retro-pc/korvet-extrom/img/top.jpg

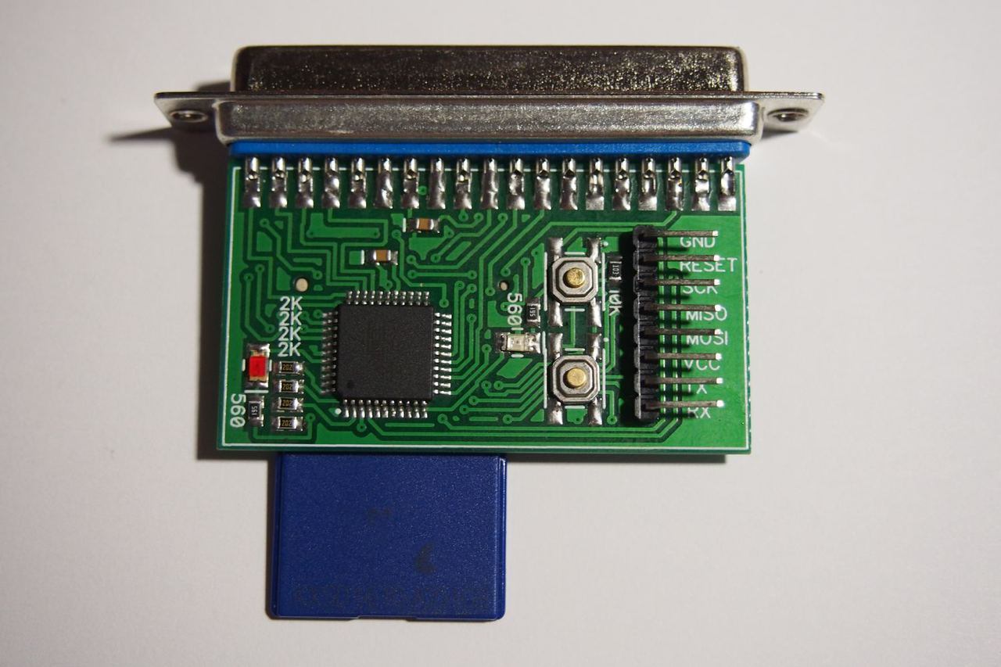
img/top.jpg
