retro-pc/korvet-extrom/img/bottom.jpg

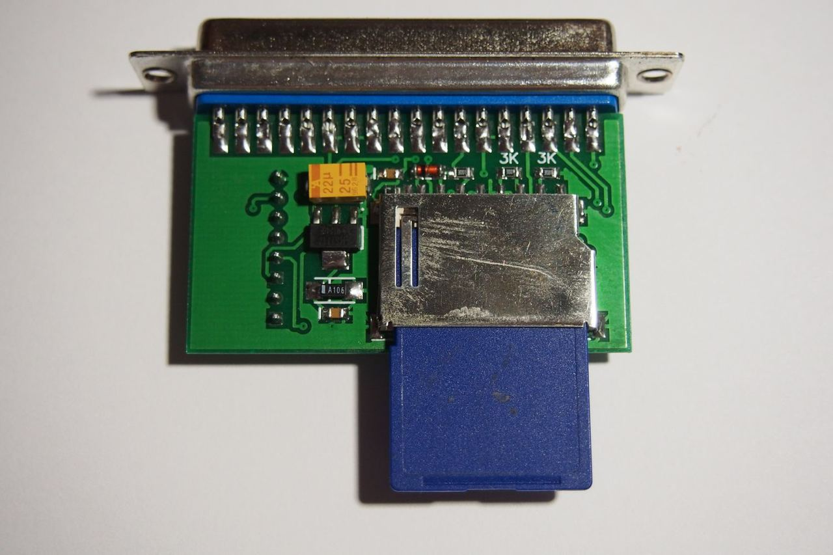
img/bottom.jpg
