retro-pc/korvet-extrom/README.md

# README #

Проект предназначен для эмуляции флоппи-дисков ПЭВМ "Корвет". Представляет собой внешний контроллер, подключаемый к боковому разъему ПЭВМ. Эмулирует до 4 дисководов (A-C) в виде образов, расположенных на карте SD. Позволяет производить загрузку системы. Работает в том числе и на ПК8010, не имеющем собственного контроллера дисковода.
