retro-pc/korvet-extrom/avr/readme.txt

2015-03-08:
 avr firmeare наконец получил номер версии, "1.3" и переформатирован.
 соответсвует последнему Stage2 (работает загрузка MicroDos)
 Stage1 перенесён с f600 на f500 т.к. портилась таблица клавиатуры в микродос.
 xboot переименова в Stage1 и добавлен скрипт его сборки
 в папку AVR добавлен скрипт заливки микроконтроллера и бинарники для прошивки.
