retro-pc/korvet-extrom/doc/hardware.odt

Korvet-EXTROM, Железо: схема, сборка и наладка.

В этом документе описывается схемотехника контроллера KORVET-EXTROM, даны рекомендации по его сборке и наладке. В принципе, грамотному электронщику читать его необязательно — для сборки и запуска достаточно принципиальной схемы и некоторого опыта наладки микроконтроллерных устройств. Однако, схемотехника контроллера довольно проста, и его сборка возможна всеми, кто умеет держать в руках паяльник и не боится им обжечься. И вот на них в основном и рассчитан дальнейший текст

1. Теория..

Основные принципы работы контроллера с программной точки зрения описаны в главном документе extrom.pdf. Здесь я опишу аппаратные особенности реализации контроллера. В принципе, для сборки и запуска контроллера данная информация не требуется, однако полезна для понимания процессов, происходящих в контроллере. Для лучшего понимания излагаемого материала желательно иметь перед глазами принципиальную схему корвета, которую легко найти в интернете

1.1 Загрузка из внешнего ПЗУ

ОПТС корвета умеет производить загрузку программ из ПЗУ, подключенного к боковому разъему. На этот разъем выведены все 3 канала параллельного интерфейса (ППИ) КР580ВВ55 #3 (эта микросхема стоит на плате рядом с боковым разъемом), а также некоторые системные управляющие сигналы и питание. ПЗУ к этому разъему подключается так: канал А ППИ подключен к шине данных ПЗУ, каналы В и С — соответственно к младшей и старшей части шины адреса. Сигнал Control через инвертор подключается к линии разрешения выхода ОЕ, а вывод CS ПЗУ заземлен. Таким образом, поддерживается ПЗУ любого объема вплоть до 64К. Реально, конечно, загрузить можно только чуть меньше 56К — младшие

8К адресного пространства заняты ОПТС, а в самых старших адресах находятся порты и АЦЗУ.

Загрузка происходит так. После окончания всех внутренних тестов, ОПТС устанавливает в 1 сигнал Control (это линия C7 параллельного интерфейса #2). Далее проверяется состояния сигнала IRQ7, также выведенного на боковой разъем. Если сигнал не изменил своего состояния, то делается вывод об отсутствии загрузочного ПЗУ и работа ОПТС продолжается как обычно. Если же сигнал IRQ7 также стал 1, то производится загрузка из ПЗУ. Следовательно, необходима перемычка между сигналами Control и IRQ7. Загрузка из ПЗУ производится в 4. этапа.

1. Из ПЗУ считывается информация о размере загружаемого блока и адресе размещения его в памяти.
2. Производится подсчет и проверка контрольной суммы ПЗУ. Если КС неправильная — загрузка прерывается с сообщением «Неверная КС».
3. 3. Из ПЗУ в оперативную память копируется весь загружаемый блок.
4. 4. Подсчитывается контрольная сумма загруженного в ОЗУ блока. Если она оказалась верной — происходит передача управления на адрес запуска, полученного ранее из заголовка.

При создании схемотехники контроллера EXTROM был учтен тот факт, что ОПТС читает ПЗУ в строго определенном порядке — байты 4, 5, 6, 7, а затем 3 раза весь блок данных. То есть четные и нечетные адреса всегда чередуются. Это позволило не подключать к контроллеру всю адресную шину (каналы B и C), а только один младший бит адреса — PB0. В самом деле — зачем нам полный адрес, если последовательность адресов заранее известна? У нас ведь используется не тупое ПЗУ, а настоящий микроконтроллер. Таким образом резко снижается количество проводов между контроллером и корветом, а канал B полностью освобождается для подключения различной пользовательской периферии — цифрового джойстика, мыши, итд.

Итак, наш контроллер умеет прикидываться внешним ПЗУ и эмулирует вышеописанный процесс загрузки. Канал А (данные) подключается к порту А микропроцессора Атmega32, единственная линия адреса PB0 — к биту 7 порта D, а сигнал Control (соединенный перемычкой с IRQ7) — ко входу внешнего прерывания INT0. По положительному фронту сигнала Control управляющая программа контроллера начинает выдавать в порт А последовательность данных, стробируясь по сигналу PD7. В результате в корвет передается блок данных размером 256 байт, содержащий загрузчик фазы 1 (что это такое и как он работает, описано в главном документе extrom.pdf). Затем загрузчик фазы 1 запускается, и далее уже самостоятельно, без участия ОПТС, взаимодействует с контроллером EXTROM.

1.2 Взаимодействие контроллера с корветом

ППИ КР580ВВ55 имеет замечательный режим работы — режим двунаправленной магистрали данных (режим 2). В этом режиме через канал А можно передавать по стробу данные как из корвета в контроллер, так и в обратную сторону. При этом данные, переданные одной стороной, защелкиваются во внутреннем регистре ППИ, и ждут, когда их заберет другая сторона. При наличии данных во внутреннем регистре выставляется флаг — OBF или IBF, в зависимости от того, в какую сторону передаются данные. Подробно, со всеми необходимыми диаграммами, этот режим описывается в документации на КР580ВВ55 (или ее прототип Intel 8255). Я же приведу список сигналов, используемых при взаимодействии контроллера EXTROM с корветом.

Ножка ППИ | Имя сигнала | Направление | Описание
PA0-PA7 | Data | I/O | Двунаправленная шина данных
PC4 | -STB | I | Запрос на передачу байта в корвет из контроллера
PC5 | IBF | O | Подтверждение приема байта корветом из контроллера
PC6 | -ACK | I | Подтверждение приема байта контроллером из корвета
PC7 | -OBF | O | Запрос на передачу байта из корвета в контроллер

После запуска загрузчика фазы 2 управляющая программа контроллера Extrom переходит в режим обработки команд. Команды формирует драйвер EXTROM, входящий в состав BIOS, или пользовательская программа (типа MOUNT). Каждая команда представляет собой 5-байтовый пакет - 1 байта кода команды, 3 байта параметров и 1 байт контрольной суммы. Драйвер последовательно записывает эти байты в порт А ППИ, который, в свою очередь, формирует строб -OBF. Контроллер EXTROM, получив строб, подтверждает прием отрицательным перепадом сигнала -ACK, и забирает данные из канала А. По окончании приема команды контроллер ее обрабатывает, и формирует ответный байт — 1 (OK) или 0 (Fail). Байт выставляется контроллером на выводы канала А и записывается в ППИ отрицательным фронтом -STB. Драйвер EXTROM, работающий в корвете, получает этот строб, и забирает данные из порта А.

Вот так происходит взаимодействие драйвера EXTROM в корвете и управляющей программы контроллера. Подробно этот протокол описывается в документе по API. В качестве примера программирования можно посмотреть исходники Extrom-BIOS (bios/exrsystem.asm) — процедуры EXR_GETBYTE и EXR_PUTBYTE, или исходники программы MOUNT — там те же самые процедуры написаны на С.

2. Схемотехника и сборка.

Теперь начинается практическая часть — как устроен контроллер и как его собрать. При изучении этого раздела следует иметь перед глазами принципиальную схему контроллера — она лежит в каталоге SCH дерева проекта. Схема нарисована в программе GPL EDA (geda), входящей в большинство дистрибутивов линукса. Для тех, кто хочет просто посмотреть схему, там же имеется вариант в виде картинки png.

2.1. Как устроен контроллер

Контроллер основан на микросхеме ATmega32 — однокристалльной микро-ЭВМ серии Atmel AVR. Она работает на частоте 8 МГц от внутреннего тактового генератора — это позволило не ставить на плату кварц и тем самым упростить схему. Питается контроллер прямо от шины +5V корвета, выведенной на боковой разъем. Собственно говоря, кроме контроллера на плате присутствует только слот для SD-карты и цепи ее питания и согласования уровней сигналов.

Дело в том, что карты SD требуют 3-вольтового питания и таких же уровней сигнала. А Atmega32 питается от 5 вольт и логические уровни у нее также 5-вольтовые. Чтобы не испортить карту, приходится устанавливать схему согласования. Она представляет собой 3 делителя напряжения — R2R6, R3R7, и R4R8. Эти делители стоят в цепях сигналов, идущих от AVR к карте (CS, DI и SCLK) и снижают уровень логической 1 до безопасных 2.8 V. Цепь R4VD2 стоит в цепи обратного (от карты в AVR) сигнала DO. Эта цепь защитная — предотвращает повреждение карты при случайном (например, из-за ошибок в программе) переключении порта PB6 на вывод. При нормальной работе эта цепь никакого влияния на сигнал не оказывает — стабилитрон VD2 всегда закрыт, а резистор R4 имеет сопротивление значительно меньшее, чем входное сопротивление порта AVR. В принципе, эту цепь можно и не ставить — стабилитрон VD2 убрать, а R4 заменить перемычкой. Управляющая программа уже отлажена и, надеюсь, таких ошибок не содержит. Однако, я бы не советовал экономить на такой мелочи — прошивка контроллера иногда обновляется, ошибки могут появиться, а убитую карту будет жалко.

Цепь питания SD-карты, формирующая напряжение 3.3V, построена на основе линейного регулятора LM317. Заменить ее можно на LM117 или LM1117 с любым буквенным индексом и в любом корпусе — потребляемый SD-картой ток очень мал, и греться микросхема не будет. В данном случае использован наиболее распространенный вариант микросхемы — с регулируемым выходным напряжением. Таких микросхем можно наковырять с неисправных материнских плат. Если повезет, то в продаже можно найти LM1117-3.3, на фиксированное выходное напряжение 3.3v — это позволит выкинуть из схемы резисторы R9 и R10. В принципе, можно еще более упростить цепь питания SD-карты — заменить LM317 на 3 последовательно включенных диода или стабилитрон 3.3v+резистор. Это уже каждый должен решать для себя сам. Я считаю, что вариант на интегральном стабилизаторе — самый безопасный для SD-карты.

Кроме AVR и цепей SD-карты, на плате также имеются 3 индикаторных светодиода (питание, Control, и активность ввода-вывода), 2 кнопки (сброс и очистка конфигурации), набор фильтровых конденсаторов, и соединители для подключения внешних интерфейсов — к корвету, программатору и терминалу.

2.2. Спецификация.

Далее приводится спецификация имеющихся на плате деталей — для зануд-педантов, и тех, кто пойдет в магазин закупать все детали за один раз.

Микросхемы
DD1 | Atmel ATmega32, с любым буквенным индексом
DA1 | LM317, LM117 или LM1117, регулируемая или с фиксированным 3.3v выходом
Диоды
VD1 | 1N4728A или любой другой маломощный стабилитрон на 3.3 или 3.0 V
VD2 | Красный светодиод с рабочим током не более 30 mA
VD3 | Желтый светодиод с рабочим током не более 30 mA
VD4 | Зеленый светодиод с рабочим током не более 30 mA
Резисторы
R1 | 560 * 0.25 W
R2-R5 | 2K * 0.25 W
R6-R8 | 3K * 0.25 W
R9 | 240 * 0.25 W
R10 | 430 * 0.25 W
R11 | 4.7 K * 0.25 W
R12-R13 | 560 * 0.25 W
Конденсаторы
C1 | 100.0 * 10V, электролитический
C2-C5 | 0.1 * 10V, керамический
C6 | 1000.0 * 16V, электролитический

Сразу хочу подчеркнуть, что не следует относиться к указанным выше номиналам как к точным и обязательным. Некоторые варианты замены деталей уже были рассмотрены выше. Рабочее напряжение керамических конденсаторов будет, разумеется, гораздо выше 10V — обычно 100V и выше. Здесь указано минимально возможное значение.Мощность резисторов необязательно должна быть именно 0.25W — можно ставить любые от 0.125 до киловатта... Их номиналы также могут изменяться в широких пределах — впрочем, если у вас есть радиолюбительский опыт, то вы сами решите, на что можно их заменить из того, что у вас лежит в загашнике. Если такого опыта нет — распечатывайте вышеприведенную таблицу, и в магазин за деталями.

Кроме вышеперечисленных деталей, потребуются еще некоторые компоненты.

- Кнопки SB1 (Config) и SB2 (Reset). Это могут быть любые кнопки, работающие на замыкание, как напаиваемые на плату, так и устанавливаемые отдельно на корпус. В принципе, для нормальной работы эти кнопки не особо и нужны — если не собираетесь заниматься доработкой контроллера и драйверов, можете их вообще не ставить.
- Разъем для SD-карты. Если готовый купить проблематично, можно выдрать из сдохшего картридера, фотоаппарата, КПК, навигатора итд. Можно установить micro-SD разъем — он компактнее. В качестве такого разъема можно использовать переходник SD-microSD, прилагающийся почти ко всем micro-SD картам, подпаявшись прямо к SD-контактам переходника.
- Разъем XP1. Это ответная часть бокового разъема корвета. В корветах применялись разные типы разъемов — и международный DB-37, и советский двухрядный РП-15-37, и трехрядный РП-15-50, может быть и еще какие-то. Если возникают трудности с приобретением ответной части данного разъема — просто замените в корвете советский разъем на стандартный DB-37, он вполне нормально подходит по размерам и впаивается в плату как родной.
- Разъем XP2. Используется для подключения отладочного терминала (описан далее). Можно установить штырьковый разъем типа IDC или PLS, в больших количествах встречающийся на материнских платах, или любой другой имеющийся под рукой 3-штырьковый разъем. Можно его вообще не устанавливать, а терминальный переходник подпаять прямо к ножке Atmega32, если терминал действительно понадобится.
- Разъем ХР3. Нужен для подключения программатора AVR, с помощью которого будет произведена запись прошивки в ATmega32. Можно также использовать IDC, PLS, если у вас уже есть готовый программатор — то надо использовать ответный разъем его кабеля. Можно просто подпаять проводки от программатора к микросхеме, или даже залить прошивку вне схемы, воткнув ATmega48 во внешний программатор — тогда разъем не потребуется.
- Колодка для микросхемы DD1 — DIP-48W. Нужна, если используется микросхема в DIP-корпусе. Если используется TQFP корпус для SMD-монтажа — то колодка, естественно, не нужна. Можно и DIP-корпус впаять прямо в плату — но лучше, все же, поставить колодку.

2.3. Конструкция.

Существует множество вариантов сборки данного устройства. Поскольку схема его предельно проста, то наиболее оптимальный вариант — сборка на макетной печатной плате навесным монтажом. Для этого потребуется небольшая макетная печатная плата, в которую с одной стороны вставляются все компоненты, а с другой стороны они соединяются монтажными проводами. Затем плата вставляется в подходящий по размерам корпус — и контроллер готов.

Другой вариант — сделать печатную плату. Этот вариант подходит только для опытных радиолюбителей, имеющих соответствующий практический навык. В результате, при использовании SMD-компонентов, можно получить очень компактную конструкцию, буквально умещающуюся в корпусе разъема. Развести плату можно в том же gEDA, в котором нарисована принципиальная схема устройства.

При сборке и разводке платы следует учитывать расположение фильтрующих конденсаторов. Керамический конденсатор С5 и электролитический C6 следует располагать непосредственно возле ввода кабеля, идущего к разъему ХР1 (или около самого разъема, если он впаян в плату). Конденсаторы С3 и С4 располагаются с обоих сторон процессора DD1, подключаясь прямо к выводам питания. Конденсатор С2 подключается как можно ближе к выводам питания SD-карты. Неправильное расположение фильтрующих конденсаторов приведет с странным и совершенно необъяснимым глюкам в работе контроллера. Земляную шину следует проложить толстым проводом по периметру платы, и стараться подключать все земляные точки непосредственно к ней. Шину питания +5V также следует выполнять более толстым проводом. В противном случае в проводах питания возникают импульсные провалы напряжения, что может вызывать сбои в работе процессора.

Отдельно требует пояснения ситуация с цоколевкой разъема ХР1. Дело в том, что нумерация выводов в стандартном разъеме DB-37 и советском РП-15-37 зеркально противоположны. На схеме указана нумерация для DB-37. В следующей таблице показано соответствие нумерации сигналов DB-37 и РП-15-37:

Сигнал | РП-9-37 | DB37
+5v | 25-27 | 30-32
A0 | 34 | 23
A1 | 35 | 22
A2 | 36 | 21
A3 | 37 | 20
A4 | 19 | 1
A5 | 18 | 2
A6 | 17 | 3
A7 | 16 | 4
Control+IRQ | 32+33 | 24+25
B0 | 3 | 17
C4 | 8 | 12
C5 | 9 | 11
C6 | 10 | 10
C7 | 11 | 9
GND | 12-13 | 7-8

Для трехрядного разъема РП-15-50 цоколевка не приводится — его у меня просто нет. С ним вам придется разобраться самостоятельно — или плюнуть на него и впаять обычный DB-37.

2.4. Сборка и начальная проверка.

Конечно, для данной схемы действует обычное правило цифровых схем — правильно собранная конструкция начинает работать сразу и в наладке не нуждается. Однако не торопитесь сразу подключать все это к корвету. Результат может оказаться совершенно другим — например, выход из строя процессора или SD-карты. Ибо собрать даже такую простую схему сразу и без ошибок удается далеко не всем. Поэтому предлагаю не торопиться.

Вначале следует аккуратно спаять схему. Процессор в колодку пока устанавливать не надо, как и SD-карту в слот. После сборки внимательно, по схеме, проверьте все соединения между компонентами. Их не так уж и много, и вся проверка займет времени не больше, чем обычно уходит на кружку пива. Лучше проверять соединения не только визуально, но и прозвонить их омметром — поскольку бывают незаметные на глаз плохие пайки. Особо тщательно вследует проверить распайку кабеля от платы до разъема ХР1 — ошибки здесь могут привести, например, к попаданию напряжения +12V на сигнальные входы процессора, что приведет к его мнгновенной смерти.

Затем схема, без процессора, подключется к выключенному корвету. Омметром вызваниваем земляную шину и шину +5V непосредственно на разъем питания корвета. Затем включаем корвет, берем вольтметр, и измеряем напряжение непосредственно на колодке процессора, между ножками VCC и GND — там должно быть от 4.5 до 5.2 V. Затем измеряем выходное напряжение LM317 непосредственно на колодке SD-карты — должно быть от 2.8 до 3.6 V.

Только после того, как вы убедитесь в правильности всех питающих напряжений, можно вставить в колодку процессор и перейти к следующему этапу — заливке прошивки.

2.5. Прошивка процессора.

В процессоре ATmega32 имеется 3 типа памяти — RAM, Flash ROM и EEPROM. Соответственно, требуется залить в него 2 отдельные прошивки — Flash и EEPROM. Первая из них — это управляющая программа процессора, вторая — загрузчик фазы 1, хранящийся в EEPROM для ускорения доступа у нему. Управляющая программа берется из файла avr/extrom.hex, загрузчик фазы 1 — из файла loader/xboot/xboot.bin.

Для заливки прошивок используется специальное устройство — внутрисхемный программатор AVR, подключающийся к разъему XP3. Программаторов существует огромное количество — как промышленных, например STK200 или STK500, так и самодельных. Множество описаний их конструкций можно найти в интернете. У радиолюбителей, имеющих дело с микроконтроллерами AVR, уже имеется какой-либо программатор. Но что делать тем, кто видит AVR впервые в жизни, и не планирует больше никогда с ними иметь дело? Можно, конечно, купить готовый простейший программатор — стоят они совсем недорого. Но можно обойтися и подручными средствами. Для этих целей давно разработана конструкция программатора, представляющая из себя 5 проводков, подключаемых к LPT-порту компьютера. То есть там кроме проводов ничего больше и нет. Вот таблица подключения сигналов программирования к LPT-порту:

Сигнал | Ножка AVR | Вывод LPT
Reset | 1 | 9
MOSI | 6 | 7
MISO | 7 | 10
SCK | 8 | 6
GND | 11 или 31 | 25

Для защиты LPT-порта лучше включить в разрыв каждого из сигнальных проводов (кроме земли, конечно), резистор 150-300 ом. Но можно и просто распаять кабель между XP3 и разъемом DF-25M. Длина такого кабеля должна быть минимальна — не более 20 см. LPT порт можно использовать как встроенный в мать, так и дополнительный на PCI/PCIE — картах.

Если в вашем компьютере совсем нет LPT-порта, то можно сделать переходник на COM-порт. Он, конечно, сложнее, но ненамного:

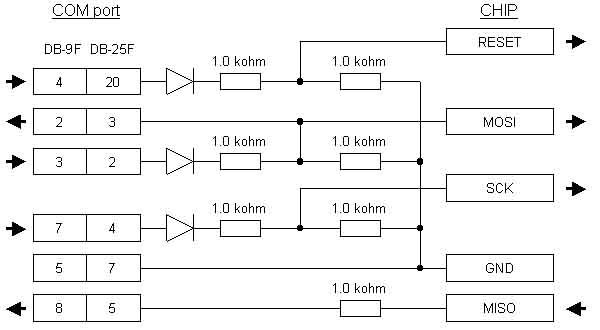
[picture p3: figure]

С этим переходником будут работать настоящие COM-порты, стоящие на материнских платах или дополнительных PCI/PCIE картах. Переходники USB-Serial, скорее всего, работать не захотят.

Для заливки прошивок потребуется специальная утилита — программатор AVR. Я рекомендую использовать широко распространенную программу AVRDUDE, имеющуюся почти во всех дистрибутивах линукса. Одним из параметров командной строки указывается тип программатора. Для 5-проводного LPT-программатора запускать программу следует так:

$ avrdude -c stk200 <ключи программирования>

Для использования программатора на последовательный порт следует предварительно отредактировать файл /etc/avrudue.conf. В этом файле следует найти такую секцию:

# unknown (dasa3 in uisp)

# reset=!dtr sck=rts mosi=txd miso=cts

programmer

id = "dasa3";

desc = "serial port banging, reset=!dtr sck=rts mosi=txd miso=cts";

type = "serbb";

connection_type = serial;

reset = ~4;

sck = 7;

mosi = 3;

miso = 8;

Здесь следует убрать знак тильды «~» в строке reset = ~4;

Ключи запуска AVRDUDE будут выглядеть так:

$ avrdude -c dasa3 -P /dev/ttyS0 <ключи программирования>

Вместо /dev/ttyS0 следует указать имя того последовательного порта, к которому подключем программатор.

Порядок прошивки будет такой — вначале устанавливаются Fuse-биты, затем заливается Flash, и потом EEPROM. Fuse-биты для нашего варианта контроллера будут такими: hfuse=0xd1 lfuse=0xe4.

Зашивка fuse-битов:

$ avrdude <ключи типа программатора> -p m32 -U lfuse:w:0xe4:m -U hfuse:w:0xd1:m

Заливка flash:

$ avrdude <ключи типа программатора> -p m32 -U flash:w:extrom.hex:i

Заливка EEPROM:

$ avrdude <ключи типа программатора> -p m32 -U eeprom:w:xboot.bin:r

Если все прошивки окончились успешно, отключите от платы программатор и нажмите кнопку Reset. Должен замигать красный светодиод VD2 — значит, управляющая программа жива и собщает нам о том, что не нашла SD-карту.

2.6. Проверка загрузчика фазы 1.

Подключите корвет к монитору, контроллер EXTROM с прошитым процессором — к боковому разъему корвета, и включите питание. На контроллере должны включиться светодиоды: зеленый (питание) и желтый (Control). Вслед за тестом ОПТС желтый светодиод погаснет, экран должен очиститься, и в верхем левом углу появится надпись BOOT:. Это говорит о том, что загрузчик фазы 1 считан из EEPROM и корректно передан в контроллер. Если все так и есть, то вам повезло и можно переходить к следующему пункту 2.6. Иначе что-то работает не так. В этом случае обращайтесь к главе 3, раздел неисправностей загрузки фазы 1.

2.7. Подготовка SD-карты

Теперь настало время заняться SD-картой. Еше раз замечу, что для работы в контроллере подходят только SD- и microSD-карты емкостью до 2Гб включительно. Более емкие карты работают по протоколу SDHC и текущей версией микропрограммы не поддерживаются. Карту необходимо отформатировать в файловую систему FAT16:

$ mkfs.vfat -F 16 -n EXTROM /dev/sdb

Обратите внимание, что MBR на карте создавать не надо. Соответсвенно, файловая система создается именно на основном устройстве (в данном случае - /dev/sdb), а не на разделе (типа /dev/sdb1). Отформатировав карту, выньте ее из картридера и снова вставьте — это позволит ОС автоматически смонтировать новую файловую систему.

Далее на карту следует скопировать ряд обязательных файлов. В следующей таблице показаны, какие файлы необходимы на карте и где их искать в дереве проекта:

Имя файла | Откуда | Описание
LOADER.BIN | loader/stage2 или loader/smldr | Загрузчик фазы 2
SYSTEM.BIN | bios/system.bin | Стандартный биос CP/M 2.2
MICRODOS.BIN | bios/microdos.bin | Стандартный биос Microdos
EXRTOOLS.DSK | mount/exrtools.dsk | Инструментальный диск
DISK/ | | Каталог по умолчанию для образов дисков
DISK/DISKA.BIN | disk/diska.kdi | Тестовый загрузочный диск с CP/M 2.2
ROM7.BIN | loader/KTDP.BIN | Диагностическая программа КТДП

Обратите внимание, что контроллер работает только с файлами, имена которых содержат только английские буквы, а длина имени не превышает 8.3 (8 байт имени и 3 байта расширения файла). Кроме вышеперечисленных файлов, в каталог DISK можно положить другие образы дисков. Если их назвать DISKB.KDI, DISKC.KDI, DISKD.KDI, то они по умолчанию автоматически смонтируются при старте системы. Можно также создать другие каталоги с образами дисков. Но это все лучше отложить на потом, когда контроллер начнет правильно функционировать.

Записав на карту все необходимые файлы, размонтируйте карту, выньте ее из картридера и вставьте в контроллер. Начинается этап окончательной проверки его работы.

2.8. Окончательная проверка контроллера.

Подключите к корвету контроллер со вставленной картой, и включите корвет. После окончания тестов ОПТС экран должен очиститься, затем будет выведена служебная информация загрузчика, стандартный загрузочный заголовок ОС CP/M и, наконец, промпт командной строки A>. Поздравляю — контроллер полностью и правильно заработал с первой попытки. Можете начинать работу с ним. Вот теперь можно забить карту под завязку образами дисков, разобраться с командой mount

и, наконец, погрузиться в 8-разрядный мир 80-х годов прошлого века.

Однако, вполне возможно, что все будет работать не так как хотелось, или вообще не заработает. Тогда вам предстоит увлекательный процесс поиска неисправности. Этому посвящена следующая глава.

3. Поиск и устранение неисправностей.

Эта глава нужна тем, у кого что-то не заработало. Если все уже работает с первой попытки — то этот раздел можно совершенно спокойно пропустить.

    3.1 Отладочный терминал.

Как и в любой уважающей себя микропроцессорной системе, в нашем контроллере имеется отладочный последовательный порт. В него контроллер выводил протокол своей работы, различные отладочные сообщения, информацию о встреченных ошибках, итд. Использование этого последовательного порта сильно облегчает жизнь в процессе отладки контроллера, а также при доработках его управляющей программы. Конечно, если у вас все уже работает, а прошивку контроллера вы дорабатывать не собираетесь, то этот порт вам не нужен. Иначе первое, что вам предстоит сделать — это подключить этот порт к своему компьютеру

Отладочный порт реализован на базе стандартного UART, встроенного в Atmega32. Используется только передатчик порта TxD, приемник RxD в текущей версии прошивки не используется, хотя драйвера для него на всякий случай туда добавлены. То есть пока мы можем только наблюдать за работой контроллера. Сигнал TxD, выведенный на разъем отладочного терминала, имеет стандартный TTL-уровень 5V с отрицательной полярностью сигнала, и непригоден для непосредственного подключения к последовательному порту PC. Требуется согласующий переходник, который можно получить разными способами.

Можно взять дата-кабель от древних сотовых телефонов. В те времена, когда телефонные аппараты не снабжались поголовно USB, для подключения к компьютеру часто использовался встроенный в телефон последовательный порт. Существовали кабели для подключения такого телефона к USB или COM-порту. Этот кабель вполне можно использовать для подключения к нашему контроллеру.

Если такого кабеля нет — а найти его с каждым годом все труднее, то можно спаять простенький переходник на последовательный порт. Состоит этот переходник из 1 инвертора:

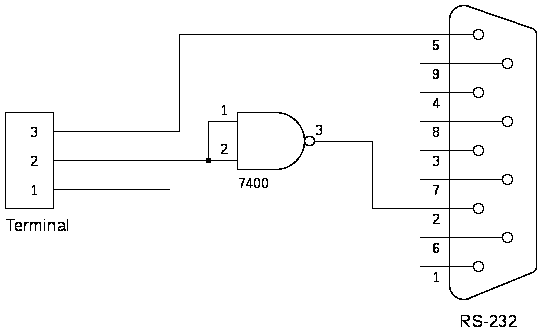
[picture p4: figure]

Здесь можно использовать любой TTL-инвертор — например К155ЛА3, К555ЛН2, ну или что у вас найдется под рукой. Запитать микросхему можно прямо от шины +5V контроллера. Такой переходник будет работать как с полноценным последовательным портом, встроенным в материнскую плату или PCI/PCIE карту, так и с USB-Serial кабелями.

Параметры последовательного порта: скорость 1000000 Bps, формат кадра — 8-N-1. Если ваш последовательный порт не умеет работать на таких высоких скоростях, то можно установить стандартную скорость 115200, пересобрав прошивку такой командой:

$ make -B LOWSPEED=1

При этом производительность контроллера может немного ухудшиться, но зато он будет гарантированно работать с любым последовательным портом.

Для наблюдения за отладочным протоколом можно использовать любую терминальную программу, понимающую кодировку UTF-8. Я рекомендую использовать стандартную терминальную программу minicom, имеющийся в каждом дистрибутиве linux. Запускать ее надо так:

$ minicom -D /dev/ttyS0 -b 1000000 -8 -R utf8 -w

Здесь ttyS0 — имя устройства последовательного порта, к которому подключен переходник (для USB-Serial кабелей будет, например, ttyUSB0 или ttyACM0). 1000000 — скорость последовательного порта, -8 — не отрезать старший бит, -w — заворачивать длинные строки, -R utf8 — кодировка символов.

Итак, подключаем отладочный терминальный порт через переходник к компьютеру, запускаем minicom, и включаем корвет. В терминале должны появиться примерно следующие строки:

*** Extrom - SD ***

CARD MID=2 OID=4d54

Product - SD02G

rev 56 serail 13224

-- Корневой каталог карты --

0: KDI2 <DIR>

1: LOADER BIN 768

2: SYSTEM <DIR>

3: SYSTEM BIN 10240

4: TOOLS <DIR>

5: ROM6 BIN 1024

6: DISK <DIR>

7: XKDI <DIR>

8: MOUNT CFG 126

9: ROM1 BIN 4608

10: ROM3 BIN 48896

11: ROM5 BIN 1024

12: KDI3 <DIR>

13: KDI4 <DIR>

14: PLDISK <DIR>

15: TD0 <DIR>

16: IC <DIR>

17: ROM0 BIN 16384

Всего 18 файлов

В первых строках идет информация о вставленной SD-карте. Затем — корневой каталог этой карты. После прохождения тестов ОПТС начнется загрузка системы, и на терминал будут выведены следующие строки:

Загрузка фазы 2

Loader file: LOADER.BIN

Loader base: 20

Loader size: 3

Block # 5

Загрузка фазы 2 окончена

Disk A: DISK/DISKA.KDI

Disk B: DISK/DISKB.KDI

Disk C: DISK/DISKC.KDI

Disk D: DISK/

Defdir: DISK

Mount A: DISK/DISKA.KDI SPT=40 st=2

Mount B: DISK/DISKB.KDI SPT=40 st=2

Mount A: SYSTEM.BIN SPT=40

RRRRRRRRRRRRRRRRRRRRRRRRRRRRRRRRRRRRRRRRRRRRRRRRRRRRRRRRRRRRRRRRRRRRRRRRRRRRRRRR

Здесь можно увидеть поблочный процесс загрузки фазы 1, процесс монтирования образов по умолчанию, и загрузку системы из образа диска А.

Если что-то пойдет не так, на терминал будет выведена информация о произошедшей ошибке. Они описаны далее, при рассмотрении различных вариантов неисправностей.

3.2 Проблемы с запуском AVR.

Может оказаться так, что после включения питания на терминал не будет выведено ничего. И красный индикаторный светодиод ни разу ни мигнет. Это означает, что наш процессор Atmega32 вообще не запускается. Причин тут может быть несколько.

- Неправильно прошиты биты FUSE. Аккуратно прошейте их еще раз. Впрочем, возможна такая комбинация битов, при которой программатор больше не сможет связаться с процессором. Например, выбрано внешнее тактирование вместо внутреннего RC-генератора. Или запрещено последовательное программирование. В этом случае придется принимать меры по восстановлению процессора. Здесь я их описывать не буду — в интернете достаточно информации о восстановлении AVR с неправильно прошитыми FUSE.

- Неправильно прошита основная прошивка. Прошейте ее еще раз, и обратите внимание на проход верификации — не появится ли там ошибок.

- Процессор не получает питания. Например, не все ножки Vcc и GND распаяны. Впрочем, в этом случае у вас вообще не получится зашить процессор.

Если процессор исправен, питается правильно, зашит корректной прошивкой и fuse, то он обязан запуститься. При этом, если красный светодиод моргает, а в терминале ничего нет — то, очевидно, у вас или неправильно собран переходник, или ваш последовательный порт не поддерживает скорость 1000000. Пересоберите прошивку на скорость 115200, как описано выше, перезашейте ее в процессор, и попробуйте запустить систему еще раз. Если и теперь терминал не заработал — то придется брать осциллограф и смотреть сигналы на выходе TxD и далее вплоть до последовательного порта компьютера. Описание работы с осциллографом выходит за рамки этого документа — если он у вас есть, то вы и так знаете как им пользоваться. Если нет — обращайтесь к знакомым электронщикам за помощью.

3.3 Проблемы с загрузчиком фазы 1.

Загрузчик фазы 1 — это небольшая программа, хранящаяся в EEPROM контроллера, и передающаяся в корвет в режиме эмуляции внешнего ПЗУ. При вынутой SD-карте этот загрузчик выводит на экран надпись BOOT: и останавливает систему. Рассмотрим возможные неисправности.

- После теста ОПТС запускается встроенный бейсик или идет загрузка с дисковода. Это происходит, если не установлена перемычка между сигналами Control и IRQ7 на разъеме XP1. Также вы могли напутать с цоколевкой этого разъема.

- При включении не зажигается желтый светодиод Control. Это значит, что сигнал Control не доходит до платы контроллера. Или он припаян не к той ножке разъема XP1, или имеется ошибка в монтаже. В редких случаях возможна неисправность ППИ2 на плате корвета.

- На экране появляется надпись «НЕПРАВИЛЬНАЯ КС». Вот тут возможно очень много вариантов.

1. Неправильно прошит загрузчик фазы 1 в EEPROM. Прошейте его еще раз, и обратите внимание на результат верификации прошивки.

2. Неправильно подключены к контроллеру линии канала данных А или адресная линия B0. Следует омметром, при выключенном корвете, прозвоить каждый из сигналов от ножек ППИ3 ВВ55 до ножек Atmega32, согласно следующей таблице:

Сигнал | Ножка ВВ55 | Ножка Atmega32
D0 | PA0(4) | PA0(40)
D1 | PA1(3) | PA1(39)
D2 | PA2(2) | PA2(38)
D3 | PA3(1) | PA3(37)
D4 | PA4(40) | PA4(36)
D5 | PA6(39) | PA5(35)
D6 | PA7(38) | PA6(34)
D7 | PA6(37) | PA7(33)
A0 | PB0(18) | PD7(21)

Нумерация выводов указана для DIP-корпуса AVR. Для TQFP-корпуса нумерация будет, естественно, другой. Сигналы следует прозванивать не только от ножки ППИ до ножки AVR, но и на соседние ножки — бывают межвыводные замыкания на плате или в кабеле.

Если все соединения правильны, то, возможно, у вас неисправен ППИ3 ВВ55, стоящий в корвете. Проверить его можно разными способами, но для большинства из них требуется, как минимум, осциллограф. Если его нет, то предлагаю методику проверки порта с помощью обычного вольтметра. Для этого нам необходмо записать в порт А микросхемы ВВ55 некоторые образцовые байты, и проверить состояние выходных ножек порта. Проверку следует производить при отключенном от разъема контроллере EXTROM.

Работать с портами можно из разных программ — под CP/M это удобнее делать с помощью отладчика DDT или системы программирования FORTH. Далее я буду использовать для этих целей встроенный бейсик. Он не так удобен, зато имеется в каждой машине. В следующей таблицы показаны адреса портов ППИ3 в адресном пространстве бейсика (карта 40h):

Порт ВВ55 | Адрес (HEX)
Канал А | FB08
-Канал B | FB09
Канал С | FB0A
Регистр управляющего слова | FB0B

Вначале надо запрограммировать ППИ в режим вывода информации. Сделать это можно такой командой:

POKE &HFB0B,0

Затем записываем ноль в канал А:

POKE &HFB08,0

Теперь берем вольтметр, и убеждаемся, что на всех выводах канала А установился логический 0 — напряжение не более 0.8 V. Затем записываем 1 в бит 0 канала A:

POKR &HFB08,1

Берем вольтметр, убеждаемся, что на выводе PA0 появилась единица — напряжение выше 3.8V. На остальных выводах канала А должен остаться 0. Теперь таким же образом последовательно устанавливаем биты 1, 2, и так далее до 7, записывая в порт FB08 числа 2, 4, 8, 16, 32, 64, 128. На соответствующей ножке канала А должна появится 1, на остальных — удерживаться 0. Если на какой-либо из ножек появляется напряжение, среднее между 0 и 1, то эта ножка замкнута на какую-либо другую или на землю. Если ножка не меняет своего состояния после записи в нее 1, то это признак неисправности ППИ ВВ55. Придется ее заменить. Новую ВВ55 лучше поставить на колодку DIP-40W.

В результате мы должны получить устойчиво запускающийся загрузчик фазы 1.

3.4 Проблемы с SD-картой.

Возможен случай, что контроллер не сможет прочитать SD-карту. Тогда в терминал будет выведена информация об ошибке — «SD карта не найдена.». Произойти это может по ряду причин.

- Использован не тот тип SD-карты, например SDHC. Контроллер поддерживает только SD-карты. Убедитесь, что емкость карты не превышает 2 Гб.

- Карта не получает достаточного питания. Прверьте вольтметром напряжение на выводе питания карты — оно должно быть в пределах 2.8 - 3.5 V. Если напряжение выходит за указанные пределы — проверяйте линейный стабилизатор питания карты и цепи его обвязки.

- Карта неправильно подключена к процессору, или использованы резисторы неправильного номинала. Проверьте омметром номиналы резисторов и правильность подключения выводов SD-карты к процессору. Кроме того, может быть неисправен стабилитрон VD1. Для проверки можно временно совсем отключить его от схемы — если все заработает, то стабилитрон необходимо заменить.

Возможен также вариант, что карта контроллером опозналась, однако драйвер FAT не смог открыть файловую систему. В этом случае в терминал будет выдано сообщение «Нет файловой системы» или «ошибки в коневом каталоге». Это может произойти по следующим причинам:

- На карте действительно нет файловой системы. Например, вы вставили в контроллер не ту карту, что заранее подготовили.

- На карте имеется MBR. Надо переформатировать карту так, чтобы файловая система начиналась прямо с блока 0.

- Используется FAT32. Переформатируйте карту в FAT16.

- Используются длинные имена файлов, или имена содержат русские буквы. Все файлы должны называться только английскими буквами, а длина имени должна укладываться в 8.3.

Если контроллер вывел на терминал список файлов корневого каталога, то файловая система признана годной.

3.5 Проблемы с загрузчиком фазы 2.

Следующая ошибка связаны с загрузкой фазы 2. Если на экране остается надпись BOOT:, а в терминал выводится ошибка “Loader file: LOADER.BIN – нет файла”, то значит вы забыли записать на карту загрузчик фазы 2 или дали ему неправильное имя. Правильное имя – LOADER.BIN. В случае битого файла будет выведено сообщение “Ошибка чтения”.

Если в терминал выводится сообщение “Загрузка фазы 2 окончена”, но при этом на экране остается надпись BOOT: или появляется мусор, то это значит, что файл LOADER.BIN не является загрузчиком фазы 2. Еще раз обращаю внимание, что загрузчик фазы 2 – это один из файлов loader/stage2/LOADER.BIN или loader/smldr/LOADER.BIN.

Можно попробовать вместо загрузчика фазы 2 запустить диагностическую программу КТДП. Для этого запишите ее из файла loader/KTDP.BIN в корень карты под именем ROM7.BIN, и затем включите корвет, удерживая нажатой кнопку 7 на клавиатуре. После запуска КТДП погоняйте в ней тесты процессора и ОЗУ – может быть, у вас неисправен сам корвет.

3.6. Проблемы с загрузкой ОС.

Если загрузчик фазы 2 запускается, но на экране не появляется промпт командной строки A>, то имеется проблема с загрузкой системных дорожек диска и запуском ОС. Возможны следующие варианты.

- На карте отсутствует файл DISK/DISKA.BIN, монтируемый по умолчанию к диску А. При этом в терминале будет выведено сообщение «Диск А — нет файла DISK/DISKA.BIN».

- На карте отсутствует BIOS по умолчанию — SYSTEM.BIN.

- На карте остался файл MOUNT.CFG от предыдущих неудачных запусков контроллера. Удалите этот файл, или просто включите контроллер, удерживая нажатой кнопку Config на нем — это приведет к пересозданию файла с параметрами по умолчанию.

3.7. Протокол обращений к контроллеру.

Для удобства отладки, при каждом обращении корвета к контроллеру, на экран отладочного терминала выводится один байт, соответствующий коду команды API. Ниже перечислены значение этих байтов:

Символ | Код команды API | Описание
0 | 00 | Пустая операция
R | 01 | Чтение данных
W | 02 | Запись данных
F | 80 | Получить имя смонтированного образа KDI
M | 81 | Монтировать образ KDI к логическому диску
Q | 82 | Узнать состояние смонтированного образаKDI
C | 83 | Создать пустой образ KDI
D | 84 | Получить список доступных KDI-файлов
U | 85 | Получить имя текущего каталога
J | 86 | Установить текущий каталог
/ | 87 | Получить список каталогов карты
| | 88 | Снять защиту записи инструментального диска
S | A0 | Установить/отключить режим подстановки системных дорожек
K | A1 | Установить/отключить реакцию на сигнал Control
U | F0 | Прием 8000h байт на максимальной скорости
Z | F1 | Передача 8000h байт на максимальной скорости
? | | Неопределенная команда.

3.8. Светодиодная индикация ошибок.

Кроме терминала, контроллер в случае возникновения фатальных ошибок, прекращает свою работу и вымаргивает код ошибки красным светодиодом. Пока определены следующие коды ошибок:

2 — не найден файл загрузчика фазы 2

3 — на SD-карте нет правильной файловой системы

4 — в корневом каталоге карты имеются ошибки

5 — SD-карта не опознана

4. Что дальше?

В конце концов, контроллер будет побежден и полностью работоспособен. Что теперь можно еще сделать? Надо обязательно сделать для платы контроллера корпус. Из пластмассы, металла, дерева — не важно. Главное, чтобы плата контроллера не валялась на столе — это для нее прямой путь в могилу.

Ну и теперь можно наконец насладиться полноценной работой с CP/M. Кто-то этим и ограничится. Но некоторые наверняка захотят модернизировать контроллер с целью добавления в него новых функций и улучшений. Разработка контроллера полностью открыта для изменений, вся документация имеется в дереве проектов. Желательно поделиться реализованными доработками с общественностью на форуме zx.pk.ru, где имеется специальный раздел, посвященный корвету.
