retro-pc/korvet-extrom/doc/api_v2.odt

Extrom-API Версии 2

Программа, выполняющаяся на корвете, обращается к контроллеру путем передачи 5-байтового командного пакета через порт А ППИ 3. После приема всех байтов команды контроллер проверяет контрольную сумму пакета и возвращает программе через тот же порт 1-байтовый ответ. Ответ может принимать значение 0 (Fail, команда отвергнута) или 1 (ок, команда принята к исполнению). Если контрольная сумма оказалась неправильной, то пакет игнорируется, а контроллер ждет следующий командный пакет, не посылая программе никаких ответов.

Формат командного пакета:

CMD: DS 1 // код команды

DRV: DS 1 // номер устройства, 0-A, 1-B, 2-C, 3-D, 4-E

TRK: DS 1 // номер дорожки

SEC DS 1 // номер сектора

CSUM: DS 1 // Контрольная сумма

Поля TRK и SEC могут имет различный смысл в зависимости от кода комнды. Контрольная сумма — это сумма всех предыдущих 4 байт пакета, и равна их беззнаковой 8-битной сумме минус 1:

CSUM=(CMD+DRV+TRK+SEC)&0xFF-1

После приема команды возможен обмен блоком данных между корветом и контроллером Размер блока и направление передачи определяется конкретной командой. Все команды делятся на 4 группы в зависимости от выполняемой функции:

0x команды ввода-вывода логических секторов

8х команды управление монтированием образов

Ax команды управления режимами работы контроллера

Fx команды для тестирования скорости интерфейса

Общий список команд контроллера приведен в следующей таблице:

Код | Передача данных | | Описание
| Направление | Размер
00 | | | Пустая операция
01 | I | 128 | Чтение данных
02 | O | 128 | Запись данных
80 | I | 29 | Получить имя смонтированного образа KDI
81 | O | 14 | Монтировать образ KDI к логическому диску
82 | | | Узнать состояние смонтированного образаKDI
83 | O | 14 | Создать пустой образ KDI
84 | I | 14*n+1 | Получить список доступных KDI-файлов
85 | I | 14 | Получить имя текущего каталога
86 | O | 14 | Установить текущий каталог
87 | I | 14*n+1 | Получить список каталогов карты
88 | | | Снять защиту записи инструментального диска
A0 | | | Установить/отключить режим подстановки системных дорожек
A1 | | | Установить/отключить реакцию на сигнал Control
F0 | I | 8000 | Прием 8000h байт на максимальной скорости
F1 | O | 8000 | Передача 8000h байт на максимальной скорости

В данной таблице (и далее по тектсу) направление передачи указано с точки зрения программы, выполняющейся на корвете. I — передача из контроллера в корвет, О — передача из корвета в контроллер. Если это поле в таблице пусто, то обмен данными данная команда не производит.

Команды ввода-вывода секторов

Группа команд 0х используется для чтения или записи секторов. Для этой группы команд доступны диски от A до Е, что соответствует полю DRV от 0 до 4.

00 — пустая операция

Эта команда всегда возвращает ответ ОК и ничего больше не делает. Она используется для проверки функционирования контроллера, а также для ожидания окончания выполнения предыдущей операции — пока контроллер не освободится, он не вернет ответ ОК. Команда логически не относится к вводу-выводу секторов, но исторически входит в группу 0х. Все параметры команды игнорируются и могут принимать любое значение.

01 — чтение сектора

Команда читает из образа диска один логический сектор размером 128 байт и передает его программе. Координаты сектора — номер устройства, дорожки, сектора — передаются в командном пакете. Если устройство не смонтировано, то обмен данными не происходит, а программе возвращается ответ Fail. Контроллер не проверяет ситуацию выхода за границы файла-образа. В таком случае результат работы команды неопределен.

02 — запись сектора

Команда принимает 128 байт данных и записывает в логический сектор образа диска. Если устройство не смонтировано, или на него запрещена запись, то обмен данными не происходит, а программе возвращается ответ Fail. Другие ошибочные ситуации команда может определить только после приема блока данных, поэтому сообщить о них программе не может. Если происходят ошибки ввода-вывода, то логическое устройство размонтируется, и следующее обращение к нему возвратит ошибку Fail.

Команды управления монтированием образов

Группа команд 8х используется для монтирования (логического подключения) файлов-образов KDI к логическим дискам. В группу входят как непосредственно команды монитрования, так и вспомогательные команды для работы со списком файлов и каталогов. Для монтирования доступны только диски А-D. Диск E всегда жестко смонтирован к файлу EXRTOOLS.DSK, и перемонтировать к другому образу его нельзя.

80 — получить имя образа

Команда предназначена для получения имени KDI-файла, смонтированного в данный момент на логическом устройстве A-D. Номер устройства задается в поле DRV. Возвращается буфер размером 29 байт, содержащий следующую информацию:

1 байт флага разрешение записи (0 — чтение/запись, 1 — только чтение)

14-байтовый буфер с именем каталога, из которого смонтирован файл образа, заканчивающийся 0.

14-байтовый буфер с именем файла, заканчивающийся 0.

81 — смонтировать образ

Команда монтирует один из имеющихся KDI-образов к логическому диску A-D. Образы должны быть расположены на SD-карте в каталоге DISK/. Параметры команды:

DRV — номер устройства

TRK — режим доступа к диску: 0 — чтение/запись, 1 — только чтение.

SEC — 0 - временное мотирование, 1 - постоянное

Постоянное монтирование позволяет сохранить связь логического диска с конкретным KDI-образом после перезагрузки системы. Для этого в корне SD-карты создается файл MOUNT.CFG, содержащий в себе имена файлов, монтируемых к дискам А и В при загрузке системы. Если такого файла нет, то он создается, а в качестве имен файлов назначаются значения по умолчанию — DISKA.KDI и DISKB.KDI.

После ввода команды контроллеру передается 14-байтовый буфер с именем назначаемого файла, окнчивающийся 0. Контроллер проверяет наличие файла и его информационный сектор, в случае ошибок монтирование не происходит, а флаг состояния устройства опускается.

82 — проверка состояния устройства

Команда возвращает ответ ОК, если устройство смонтировано, или Fail, если не смонтировано. Флаг состояния автоматически опускается в случае ошибок ввода-вывода на данном устройстве. С помощью этой команды можно проверить результат предыдущего вызова mount (81)

83 — создать образ

Команда создает на SD-карте пустой KDI-файл с указанным именем, формирует в нем инфосектор и пустой каталог. Команде надо передать 14-байтовый буфер с именем создаваемого файла. Если файл существует, то он будет полностью затерт с потерей всей информации. После создания файл автоматически монтируется на указанный в DRV диск.

На данный момент создается стандартный KDI-файл размером 800К. В будущем планируется добавить параметры для создания файла произвольного размера.

84 — получить список образов

Команда предназначена для просмотра списка всех KDI-файлов, имеющихся на карте. Она отдает цепочку строк размером 14 байт для каждого из имеющихся файлов. Признаком конца цепочи является единственный байт 00, возвращаемый вместо 14-байтовго буфера.

85 — Получить имя текущего каталога

Если бы все образы дисков сваливались в корень карты, то там быстро наступил бы бардак, в котором практичсески невозможно найти нужный образ. Поэтому контроллер дает возможность разложить файлы в несколько каталогов, создаваемых в корне карты. Глубина вложенности каталогов — 1, то есть каталог внутри каталога создавать нельзя, контроллер его не увидит. Команда 85 возвращает имя текущего каталога, того, в котором контроллер будет искать вновь монтируемые образы дисков. После ввода команды контроллер отвечает 1 (ОК) и передает 14-байтовый буфер с именем каталога.

86 — Установить каталог по умолчанию

Эта команда устанавливает каталог по умолчанию. После ее выполнения все вновь монтируемые образы дисков контроллер будет искать именно в этом каталоге. Если параметр SEC=0, то текущий каталог устанавливается временно, до выключения питания или перезагрузки. При SEC=1 текущий каталог записывается в файл конфигурации MOUNT.CFG и будет сохранен после перезагрузки. После ввода команды контроллер отвечает 1 (ОК) и принимает 14-байтовый буфер с именем каталога. Если указанный каталог не существует на карте, то назначение не выполняется — сохраняется прежний каталог по умолчанию. Это можно проверить с помощью команды 85.

87 — получить список каталогов

Команда предназначена для просмотра списка всех каталогов, имеющихся на карте. Она отдает цепочку строк размером 14 байт для каждого из имеющихся в корне карты каталогов. Признаком конца цепочи является единственный байт 00, возвращаемый вместо 14-байтовго буфера.

88 — снять защиту записи с диска E.

Команда предназначена для разрешения записи на инструментальный диск E. Обычно в процессе работы этот диск всегда защищен от записи во избежании случайного его повреждения. После команды 88 контроллер открывает запись на этот диск, что позволяет, например, обновить хранящиеся на нем программы. Команда не имеет параметров и всегда возвращает ответ 1 (ОК). Разрешение записи будет действовать до следующей перезагрузки контроллера.

Команды управления режимами контроллера

A0 — режим подстановки системных дорожек

Режим подстановки системных дорожек используется для принудительной загрузки в корвет специализированной версии CP/M со встроенными драйверами Extrom-API. Если происходит чтение дорожки 0 или 1 диска А, то вместо содержимого смонтированного образа подставляются сектора из специального файла, лежащего в корне SD-карты. Это позволяет монтировать к А любой образ с любым содержимом системных дорожек, поскольку загрузка ОС будет происходить из системного файла, а не с реального диска.

Для возможности загрузки других биосов и получения доступа к реальным системны дорожкам диска А такой режим работы может быть отключен командой A0. Параметры команды:

DRV — всегда 0.

TRK — 0-выключить режим подстановки,

1-подставлять файл SYSTEM.BIN (там лежит специальная версия CP/M 2.2)

2-подставлять файл MICRODOS.BIN (там лежит специальная версия microdos)

3-подставлять файл SYSTEMn.BIN, где n-значение параметра TRK. Это задел на будущее.

A1 — управление сигналом Control

Сигнал Control, выходящий из бита 7 канала С порта PPI2, используется контроллером Extrom для синхронизации начальной загрузки, а после окончания загрузки используется для определения момента перезагрузки корвета. Дело в том, что несознательные разработчики корвета проявили потрясающее разгильдяйство, не выведя на боковой разъем такой важный сигнал, как Reset. В результате приходится определять перезагрузку корвета по уходу этого сигнала в 0 (что происходит при аппаратном сбросе ВВ55). Но проблема уперлась в то, что некоторые умники, пишущие программы для корвета, считают своим долгом дергать этот сигнал как угодно, даже без определенной цели. В результате контроллер уходит в перезагрузку, а программа, работающая на корвете, теряет доступ к диску. Чтобы избежать этой ситуации, и используется данная команда. В поле TRK указывается 0 — запретить перезагрузку от Control, или 1 — разрешить ее. В режиме запрещения перезагрузки, если нажать кнопку Reset корвета, получим на экране сообщение Ошибка шины. В этом случае надо или отключить и снова включить питание, или нажать кнопку сброса на самом контроллере.

Команды измерения скорости

F0 — тест скорости чтения

Команда используется для измерения скорости передачи из интерфейса в корвет. Она передает 8000h произвольных данных единым блоком на максимально возможной скорости.

F1 — тест скорости записи

Команда используется для измерения скорости передачи из корвета в интерфейс. Она также передает 8000h произвольных данных на максимально возможной скорости, только уже в обратную сторону.
