retro-pc/korvet-extrom/doc/extrom.odt

Korvet-EXTROM

Проект EXTROM является аппаратным эмулятором дисковых накопителей для ПЭВМ «Корвет».

1. Что это такое и зачем его создавали

В давние 80-е годы прошлого века в нашей стране начали появляться первые бытовые персональные ЭВМ. Радио-86РК, ZX Spectrum, ОРИОН-128... Много их было. В качестве носителя информации они использовали обычный бытовой кассетный магнитофон. И у каждого обладателя такой ЭВМ была заветная мечта — подключить к своей машине настоящий дисковод. Только вот дисководы тогда были в дефиците, да и стоили очень приличных денег — далеко не каждый мог себе его позволить. Шли годы. Дисководы стали неотъемлемой частью любого персонального компьютера, появились HDD, различные оптические диски, и, наконец, Flash-накопители. Ленточные магнитофоны ушли в историю, туда же практически уже отправились и дисководы FDD. На современных материнских платах часто уже не ставят FDD-разъемов, а крупные фирмы понемногу сворачивают выпуск дискет. Оно и понятно — на MicroSD карту размером с ноготь мизинца информации влезает больше, чем в целый шкаф, забитый дискетами, они не боятся магнитных полей, не обсыпаются от времени. Скоро FDD, бывшие когда-то несбыточной мечтой, навсегда исчезнут из вычислительной техники.

Бытовые ПЭВМ 80-х—90-х годов также в большинстве своем обрели покой на помойках. Остались они в основном в музеях, да у некоторых олдфагов-энутзиастов, любящих поностальгировать со старыми игрушками. ПЭВМ Корвет, о которой пойдет речь далее, повезло чуть больше. Она была принята в качестве официального школьного компьютера, и такими ЭВМ (в виде комплектов КУВТ) оснащали школьные компьютерные классы. Поэтому высока вероятность, что этих ПЭВМ сохранилось не так уж и мало в различных школьных запасниках. Существовало 2 варианта поставки школьных Корветов: полноценный ПК8020 и обрезок ПК8010. Первый был укомплектован всеми периферийными портами и двумя дисководами, кроме школ поставлялся в различные учреждения и, возможно, даже попадал в розничную продажу. В учебных классах он выполнял роль рабочего места преподавателя (РМП). Существовали также клоны этой машины под другими торговыми марками, например ПК Контур. ПК8010 существовал только как составная часть школьного комплекта КУВТ. Он не имеет в себе порта принтера, RS-232 и контроллера дисковода, и в школьных учебных класса был рабочим местом ученика (РМУ) — по 15 РМУ на один РМП. Отсутствие дисководов делает этот компьютер практически бесполезным — на нем можно только поразвлекаться с бейсиком, да позагружать специальным образом подготовленные игры через порт магнитофона или локальную сеть. Другое дело — ПК8020. Наличие дисковода позволяет использовать на нем ОС CP/M, широко распространенную в мире в 80-е годы прошлого века. Под эту ОС существует море прикладных программ, например вполне серьезная СУБД DBASE-II, трансляторы с большинства распространенных в ту пору языков программирования, и другой полезный софт. Ну и, кроме того, под сам Корвет написаны десятки отличных игрушек и обучающих программ. В общем, побаловаться с такой машиной многим было бы интересно, если бы не одна важная проблема.

В те далекие годы дисководы 3.5", стоящие сейчас в персональных компьютерах, только начали появляться в природе. Во всех распространенных машинах использовались дисководы 5" и даже 8". В стандартной комплектации Корвета имелись два дисковода по 5", с потенциальной возможностью подключения еще двух. Сейчас, в 21 веке, 5" дискеты найти уже нереально — их давно не выпускают, а существующие в основном отправились в помойку. Но даже если на дальней полке чердака найдется-таки пачка таких дискет — их просто не на чем будет записать. Уже лет 15 такие дисководы в компьютеры не ставят. Да и не факт что они запишутся — за столько лет их магнитный слой мог постареть и обсыпаться.

В интернете можно найти неплохую коллекцию образов реальных корветовских дискет. Эти файлы имеют тип *.KDI и являются посекторными копиями реальных дискет. Только вот как их использовать на Корвете? Первый, бросающийся в глаза вариант — подключить к Корвету современный 3.5" дисковод. Записать образ диска на такую дискету и наслаждаться. Решение очевидное, но имеет в себе некоторые изъяны. Во-первых, и 3.5 дисковод теперь попадается далеко не в каждой машине. И хорошие дискеты так просто не купишь, а те, что продаются, обладают отвратительнейшим качеством. Во-вторых, переходник для подключения дисковода придется спаять своими руками — готового такого не купишь. И есть проблема с получением сигнала RDY, отсутствующего на 3.5" дисководах. А тем, кому достался вариант ПК8010 из школьного класса КУВТ, и вовсе не повезло — к их машинам дисковод не подключишь. Можно, конечно, допаять на системную плату недостающие компоненты и сделать из него ПК8020, но далеко не все на такое способны, да и муторно это.

Учитывая все вышеизложенное, и был сделан проект Korvet-EXTROM. Он представляет собой небольшую электронную плату - контроллер, подключаемый в разъем расширения (боковой разъем), имеющийся на каждом Корвете, даже на ПК8010. После этого Корвет получает в свое распоряжение до 4 виртуальных дисководов, к каждому из которых можно примонтировать файл-образ дискеты KDI и полноценно им пользоваться в ОС CP/M. Сами образы хранятся на карте SD, отформатированной в файловою систему FAT и также подключенной к контроллеру. Специальный программный интерфейс позволяет на ходу подмонтировать к любому виртуальному диску любой файл-образ, хранящийся на карте. Нетрудно представить, что при скромной емкости карты в 2 Гб туда можно поместить более 2500 образов (размер образа — 800к), что намного превышает весь объем программного обеспечения, существующего для Корвета. Таким образом, в маленькой коробочке можно собрать весь софт, который когда-либо может понадобиться, и забыть о дисководах навсегда.

2. Копирайты и т. д.

Вам интересно об этом читать? Вот и мне также неинтересно об этом писать. Все равно никто не читает. Так что проехали.

3. Как оно работает.

Резидентный монитор ОПТС, хранящийся в ПЗУ Корвета и осуществляющий его первоначальный запуск, обладает интересной особенностью. Если к боковому разъему подключить ПЗУ с записанной в ней специальным образом сформированной программой, и замкнуть между собой на этом разъеме сигналы Control и IRQ, то вместо загрузки системы с дисковода или запуска встроенного бейсика будет запущена программа, находящаяся в этом ПЗУ. Разработчики, видимо, использовали эту возможность для заводского тестирования машины, ну и предполагали создание картриджей с программами, как это было сделано на игровых компьютерах (типа ATARI 800 например) и телевизионных игровых приставках. На практике эта возможность использовалась разве что для организации линтеховской сети NET-CP/M. Сейчас это оказывает нам просто неоценимую услугу. После включения питания контроллер Extrom имитирует внешнее ПЗУ (отсюда и его название) и передает в Корвет маленькую, размером 256 байт, программку, называемую загрузчиком 1 фазы. Этот загрузчик, получив управление, устанавливает двустороннюю связь с контроллером, загружает оттуда следующую программу — загрузчик 2 фазы, и запускает его. Загрузчик 2 фазы функционирует примерно так же, как дисковый загрузчик ОПТС — считывает с виртуального диска А информационный сектор, образы системных дорожек, размещает их в памяти и передает туда управление. Кроме того, он может перед запуском произвести модификацию загруженной ОС, встраивая в нее драйвер для работы с виртуальными дисками. После запуска ОС выдает на экран стандартный промпт А> и готова к приему команд.

При работе ОС доступны 6 логических дисков — от А до F. Диск F — это электронный RamDisk, размещенный в памяти ГЗУ и целиком эмулирующийся средствами BIOS. Диск E — инструментальный диск, содержащий программы управления контроллером (MOUNT, CONTROL и EUNLOCK). Он всегда связан с образом EXRTOOLS.DSK, лежащим в корне SD-карты. Остальным дискам А-D можно сопоставить или виртуальный диск, эмулируемый контроллером, или один из четырех реальных дисководов. Делается это через программный интерфейс (API) контроллера с помощью специальной программы MOUNT (она входит в дерево проекта) или другой подобной программы, написанной пользователем.

Для доступа к виртуальным дискам контроллер предоставляет специальное API, подробно описанное в соответствующем документе. Доступ к дискам через API требует доработки BIOS — вставки в него интерфейсных драйверов. Эта работа может быть выполнена или заранее (в дереве проекта имеется уже готовая ОС CP/M 2.2 со всеми встроенными драйверами) или прямо в процессе загрузки конкретной ОС с диска. Эта задача возложена на загрузчик 2 фазы. Подробное описание работы загрузчиков приведено далее, а их исходные тексты находятся в дереве проекта.

4. Схемотехника контроллера EXTROM

Подробно принципиальная схема контроллера, его сборка и наладка описаны в соответствующем документе hardware.pdf. Здесь дается только краткое описание.

Контроллер построен на основе микроконтроллера ATMega32 фирмы Atmel. В принципе, можно использовать и более старшие процессоры — ATmega64 или даже 128, но это потребует некоторой правки программы, да и бессмысленно, поскольку большая часть ресурсов процессора все равно пропадет впустую. Кроме процессора, в контроллер входят 12 резисторов, 5 конденсаторов, 1 стабилитрон, 2 кнопки, одна микросхема регулятора напряжения LM317, гнездо для SD-карты и разъем для подключения к Корвету. Принципиальная схема контроллера находится в каталоге SCH проекта. Она сделана как можно проще и доступна для сборки любому человеку, умеющему держать в руках паяльник.

Кроме кучки радиодеталей и монтажной платы, для первоначального запуска контроллера потребуется программатор, поддерживающий работу с микросхемами Atmel AVR — для записи прошивки в процессор. Можно или взять готовый программатор — они копейки сейчас стоят, или сделать времянку из пяти проводков на LPT порт. Подробно все это описано в файле hardware.pdf.

5. Замечание об используемых инструментах

Весь проект доступен в исходных текстах. Но для сборки входящих в Корвет программ требуются дополнительные программные средства. Для сборки прошивки контроллера нужен пакет AVR-GCC. Он имеется в большинстве дистрибутивов Linux-систем. Для сборки загрузчиков и образа системы CP/M потребуется кроссассемблер Z80. Их много есть на свете, но я использовал ассемблер ZMAC. В обычные дистрибутивы он не входит, а взять его можно здесь - http://members.shaw.ca/gp2000/zmac.html . Готовый к употреблению вариант этого ассемблера входит в дерев проекта — каталог zmac. И, наконец, для сборки программы mount потребуется компилятор С80 под CP/M. Он есть на прилагаемом к проекту образе диска с исходниками программы mount (mount/mount.kdi).

Для тех, кто не хочет ничего собирать, в дереве проектов имеются уже готовые собранные двоичные файлы прошивки и загрузчиков.

Все инструменты, сброчные скрипты, описания, примеры и прочее рассчитаны на использование в операционных системах семейства Linux. Пользователям других альтернативных операционных систем придется или поставить Linux, или разбираться самостоятельно, как все эти действия выполнять в их ОС. Впрочем, для простой сборки и запуска контроллера в работу потребуется только программатор AVR и, пожалуй, все.

6. Структура файловой системы SD-карты

Контроллер поддерживает SD-карты объемом до 2 Гб. Более емкие SDHC карты не поддерживаются — не имеет смысла. Карта должна быть отформатирована в файловую систему FAT16. FAT32 контроллером не поддерживается, будьте внимательны! Это можно сделать, например, так (предполагаем, что карта подключилась к устройству /dev/sdb):

$ mkfs.vfat -F 16 -n EXTROM /dev/sdb

Корневой каталог карты предназначен для хранения служебных файлов, используемых контроллером при работе. Там размещены следующие файлы:

- LOADER.BIN — загрузчик фазы 2 по умолчанию.
- ROMn.BIN — системнонезависимые программы, запускаемые вместо загрузчика при нажатии клавиш 0-7 на клавиатуре. Всего может быть 8 файлов от ROM0.BIN до ROM7.BIN. Наличие этих файлов на карте необязательно.
- SYSTEM.BIN — Образ системных дорожек CP/M 2.2, используемый в режиме подстановки.
- MICRODOS.BIN — Образ системных дорожек ОС МикроДОС, используемый в режиме подстановки.
- MOUNT.CFG — файл конфигурации монтируемых по умолчанию образов. Файл создается автоматически при первом запуске контроллера, вручную его править нежелательно.
- EXRTOOLS.DSK — образ инструментального диска, доступного через логическую букву Е, и содержащий программы управления контроллером MOUNT, EUNLOCK и CONTROL.

Все другие файлы, лежащие в корне карты, контроллером игнорируются, выполняющейся на Корвете программе недоступны и могут содержать что угодно. Структура и назначение системных файлов подробно описаны далее.

Также на карте расположены один или несколько каталогов, содержащих образы дисков *.KDI. Из любого каталога любой образ можно смонтировать к любой из 4 логических букв диска. Обязательным является наличие каталога DISK — в нем будут по умолчанию искаться образы при первом включении или сбросе конфигурации. Остальные каталоги можно создавать по желанию для удобства хранния и использования коллекции образов.

7. Процесс загрузки системы

Как выше уже отмечалось, загрузка операционной системы происходит в 2 этапа. В этом разделе данный процесс рассматривается подробно.

7.1 Фаза 1 процесса загрузки

Фаза 1 начинается после нажатия кнопки Reset или включения питания Корвета. ОПТС, по окончании всех своих тестов, проверяет, не замкнуты ли между собой сигналы Control и IRQ на боковом разъеме. И если замкнуты — начинает процесс загрузки из ПЗУ, подключенного к этому разъему. Таким образом, для загрузки ОС не нужно выполнять никаких действий — достаточно включить питание при подключенном к боковому разъему контроллере. Контроллер эмулирует внешнее ПЗУ и передает в Корвет небольшую программу, называемую загрузчиком фазы 1.

Загрузчик фазы 1 — это небольшая (256 байт) программка, предназначенная для передачи в Корвет из контроллера системнонезависимых программ любого объема. В отличие от всех остальных программных компонентов, этот загрузчик располагается не на SD-карте, а в EEPROM контроллера. Это необходимо для ускорения доступа — процесс загрузки фазы 1 жестко ограничен по времени, поскольку ОПТС не имеет никакой информации о готовности данных контроллера. Поэтому данный загрузчик будет запускаться всегда, даже при отсутствии в контроллере SD-карты. Данная особенность позволяет уже на ранних этапах сборки контроллера (до распайки SD-разъема) проверить правильность подключения к интерфейсному разъему Корвета, а также исправность периферийного адаптера КР580ВВ55, стоящего на плате Корвета и подключенного к боковому разъему.

Получив управление, загрузчик выводит на экран надпись BOOT:, настраивает порт А ВВ55 в режим двухстороннего обмена (режим 2), и проверяет состояние клавиатуры. Если нажата одна из кнопок 0-7, в интерфейс передается байт 00-07, в зависимости от нажатой кнопки. Если ни одна из кнопок не нажата, передается байт 08. Контроллер принимает этот байт, и ищет на карте файл для загрузки следующей фазы. Имя файла — LOADER.BIN, если на клавиатуре не нажата ни одна кнопка, или ROMn.BIN (n=0..7), если нажата кнопка 0-7. Таким образом, на карте можно иметь 7 системнонезависимых программ и выбирать, какую из них загружать, просто удерживая одну из кнопок 0..7.

Файлы, содержащие системнонезависимые программы, имеют такой же формат, как программы, предназначенные для загрузки непосредственно из внешнего ПЗУ, подключенного к Корвету. Более подробно этот формат описан в документе api_v2.pdf. Одной из этих программ является загрузчик фазы 2 LOADER.BIN, запускаемый по умолчанию. Кроме того, на карте в файлах ROMn.BIN можно разместить тестово-диагностическую программу КТДП, различные системнонезависимые игрушки, а также программы, написанные пользователем с учетом требований к системнонезависимым программам.

Протокол взаимодействия загрузчика фазы 1 и контроллера описан в документе api.pdf. После передачи в Корвет этого загрузчика контроллер разбирает файл конфигурации MOUNT.CFG (или создает его при отсутствии), монтирует образы KDI к логическим дискам A-D и переходит в стандартный режим обработки запросов через командный протокол.

Полный исходный текст загрузчика находится в дереве проекта, в файле loader/xboot/xboot.asm. А в файле loader/xboot/ercs.c находится утилита, формирующая из сырого двоичного файла, получаемого при трансляции загрузчика, образ, пригодный для загрузки в Корвет средствами ОПТС. Готовый оттранслированный образ загрузчика, готовый для записи в nvram контроллера, лежит в файле loader/xboot/xboot.bin

7.1 Фаза 2 процесса загрузки

Загрузчик фазы 2 находится на карте в файле LOADER.BIN, и получает управление от загрузчика фазы 1. Его задача — загрузка и запуск ОС CP/M (или МикроДос). Этот загрузчик уже взаимодействует с контроллером через стандартный протокол API v2. Он выполняет следующие действия:

- Читает из образа диска А сектор 0 (информационный сектор), проверяет его, получает из него параметры загрузки, логические и физические параметры диска.
- Загружает содержимое системных дорожек диска А в память, начиная с адреса загрузки, указанного в информационном секторе.
- Определяет версию BIOS загруженной системы
- Встраивает в BIOS драйвера для взаимодействия с контроллером EXTROM
- Определяет наличие контроллера FDC на системной плате, и принимает решение, отображать ли диски C и D на реальные дисководы или на эмулируемые диски.
- Передает управление загруженной системе на точку входа BOOT.

Если информационный сектор не содержит параметров загрузки (образ диска незагружаемый), или загрузчик не смог определить версию BIOS, то включается режим подстановки системы. В этом режиме содержимое системных дорожек берется не из образа диска А, а из специального файла, называемого стандартной системой. Для CP/M этот файл называется SYSTEM.BIN, для МикроДос — MICRODOS.BIN. При этом контроллер автоматически определяет, происходит ли обращение к системным дорожкам диска А, и автоматически подставляет сектора из указанных файлов. Такой режим работы позволяет загрузить полноценно функционирующую ОС при абсолютно любом содержимом диска А. Также можно включить режим подстановки принудительно, удерживая кнопки CTRL и SHIFT в процессе загрузки системы. Это позволяет загрузить стандартную систему независимо от версии ОС, записанной на диске А.

Исходные тексты загрузчика фазы 2 находятся в каталоге loader/stage2. Готовый для записи на карту двоичный образ загрузчика лежит в файле loader/stage2/loader.bin.

7.3 Упрощенная фаза 2.

Если не требуется возможность загрузки любой имеющейся системы, то можно сделать так, чтобы всегда грузилась стандартная ОС CP/M или Микродос. Для этого существует упрощенный загрузчик фазы 2, находящийся в дереве проекта в loader/smldr/loader.asm. Этот загрузчик не производит анализ имеющейся на диске А системы, а проверяет только информационный сектор, и, в зависимости от числа системный дорожек, грузит стандартную CP/M (2 дорожки) или МикроДОС (3 дорожки). Данный упрощенный загрузчик помещается на карту в файл LOADER.BIN вместо полного. Кроме того, можно иметь на карте как полный, так и упрощенный загрузчики, поместив один из них в файл LOADER.BIN, а другой, например, в ROM0.BIN.

8. Работа с системой

В принципе, работа с ОС, загруженной с эмулируемого диска, практически ничем не отличается от работы с ОС, загруженной с реальной дискеты. ОС вообще не видит разницы между физическим и эмулируемым диском. Однако имеются и некоторые особенности, которые надо обязательно учитывать.

8.1 Прямой доступ к диску.

Некоторые прикладные и системные программы работают с диском не через стандартные вызовы BDOS/BIOS, а непосредственно через порты контроллера FDC. Так поступают, например, программы форматирования дисков (типа FORMAT.COM), дисковые копировщики, диагностические программы типа OLD. Все эти программы, естественно, не смогут получить доступ к эмулируемым дискам, поскольку ничего не знают о контроллере EXTROM и его API. Вместо этого они начинают работать с реальным дисководом. То есть для всех этих программ диск А — это физический дисковод 0, диск В — физический дисковод 1, и т. д. Такое поведение программ следует учитывать: FORMAT A: отформатирует именно реальную дискету в дисководе, а не виртуальный диск. Копировщик дисков будет копировать посекторный образ именно с дискеты А на дискету B, независимо от конфигурации логических дисков. Поэтому, если вам надо отформатировать дискету в дисководе 0, то надо вводить команду FORMAT A:, а не FORMAT C:, даже если физический дисковод отображается на букву С.

Если на системной плате нет контроллера FDC (ПК8010), то поведение таких программ вообще непредсказуемо, поскольку они на такое не рассчитаны — обычно на ПК8010 запустить FORMAT.COM физически невозможно.

8.2 Работа с портами периферийного контроллера ВВ55 #3.

Есть такие программы, которые лезут в порты ППИ ВВ55, выведенного на боковой разъем, к которому и подключается контроллер EXTROM. Порты эти расположены по адресам FB08-FB0B в стандартной карте памяти CP/M (карта 1С). В этот порт программы лезут по разным причинам. Некоторые используют подключенные к боковому разъему нестандартные периферийные устройства — например цифровой джойстик или мышь. Другие — для диагностических целей (например, ОПТС использует канал А для проверки шины данных периферийных контроллеров). Третьи — просто так, по дурости и разгильдяйству разработчиков.

В результате работы таких программ нарушается нормальное взаимодействие между драйверами эмулируемых дисков и контроллером EXTROM. Это приводит к зависанию или бесконечным ошибкам ввода-вывода при первом же обращении к диску. Выйти из этого состояния можно только перезагрузкой системы (кнопкой Reset или отключением-включением питания). К сожалению, универсального рецепта для обхода данной ситуации не существует. Единственный возможный путь — брать отладчик и править код программы, выкидывая из нее все обращения к портам FB08-FB0B. В этом неоценимую помощь оказывает эмулятор Etalon Korvet Emulator, доступный в исходных тестах и имеющий встроенный развитый отладчик.

Исключением могут стать программы, работающие с джойстиком или мышью. Они взаимодействуют только с каналом В, который для доступа к дискам не используется (к контроллеру Extrom подключен только младший бит DB0, но используется он только на этапе загрузки ОС). Правда, эти программы портят управляющее слово (CWR, порт FB0B), но оно будет восстановлено при первом же обращении к дисковому драйверу.

8.3. Сигнал Control.

Еще одна головная боль, достаточно часто возникающая при работе с EXTROM — это сигнал Control. Так называется бит 7 канала С параллельного периферийного контроллера 2 (порт FB33). Это очень важный для контроллера EXTROM сигнал — он используется для синхронизации процесса начального запуска контроллера, и он же нужен для отслеживания момента перезагрузки Корвета. Дело в том, что мудрые разработчики Корвета вывели на боковой разъем огромную кучу сигналов, вплоть до напряжения -12В и импульсов от системного таймера. А такой важный сигнал как RESET туда вывести забыли. В результате устройство, подключенное к боковому порту, не сможет отследить момент перезапуска Корвета. Далее, в процессе начальных тестов ОПТС производит так называемый тест шины данных. Сводится это к тому, что в канал А ППИ3 записывается несколько тестовых образцов, которые потом оттуда читаются и проверяются. Если считанное значение не совпало с записанным — выдается сообщение НЕИСПРАВНОСТЬ ШИНЫ и процесс загрузки останавливается. Авторы ОПТС, не учли, что к боковому разъему Корвета может быть подключено нестандартное периферийное оборудование, разработанное самим пользователем (для чего, собственно, этот разъем и предназначен). И если какие-либо из линий канала А этим оборудованием подтянуто к земле, то записанные в канал данные НИКОГДА не совпадут с прочитанными. Все это сильно усложняет жизнь разработчикам периферии.

Вот тут-то и приходит на помощь сигнал Control, также имеющийся на боковом разъеме. В момент включения Корвета, в процессе тестов ОПТС, и после нажатия кнопки Reset этот сигнал становится равным нулю. Когда ОПТС заканчивает свои тесты и готовится к загрузке системы, сигнал становится равным 1. Таким образом контроллер EXTROM и узнает, что именно надо делать в данный момент. При 0 он перезапускает свою микропрограмму, отключается от канала А и ждет перехода Control в 1. При 1 он подключается к каналу А и начинает процесс передачи загрузчика фазы 1.

Сигнал Control настолько важен, что в контроллере EXTROM предусмотрен индикаторный светодиод, отображающий его состояние. Когда индикатор включен — сигнал Control=0. Когда гаснет — Control=1. При включении питания или нажатия кнопки Reset индикатор зажигается, перед началом загрузки ОС — гаснет и больше в процессе работы ОС уже не включается.

Но есть некоторые программы, которые в процессе своей работы изменяют сигнал Control. Дело в том, что канал С, кроме Control, содержит также достаточно широко используемые линии управления звуком, кассетным магнитофоном и принтером. Манипулируя этими сигналами, некоторые программы случайно могут изменить и значение бита 7, обнулив сигнал Control. Это приводит к ложному рестарту контроллера Extrom и потере доступа ко всем эмулируемым дискам. Такая ситуация хорошо видна по индикаторному светодиоду — если он включился в процессе работы прикладной программы, то значит программа обнулила сигнал Control и дальнейшая работа невозможна.

Данная ситуация возникала настолько часто, что в API контроллера была введена специальная команда — подавление реакции на Control. При этом контроллер EXTROM отключается от сигнала Control и больше не реагирует на его изменение. Однако, результате контроллер теряет возможность отследить момент перезагрузки Корвета кнопкой Reset. Теперь перезагрузка возможна только отключением-включением питания.

Управлять этим режимом работы можно с помощью программы CONTROL, имеющейся на инструментальном диске Е. Формат команды:

CONTROL OFF

— отключает реакцию контроллера на сигнал Control. Используется перед запуском программ, некорректно работающих с этим сигналом.

CONTROL ON

— включает обработку сигнала Control обратно (это режим по умолчанию).

9. Управление логическими дисками

При работе с реальными дискетами можно вынуть дискету из дисковода и вставить вместо нее другую. В случае эмулируемых дисков данная операция выполняется с помощью монтирования образов дисков. Монтирование — это логическое связывание буквы диска А-D с конкретным образом KDI или реальным дисководом. В любой момент времени любой из 4 дисков можно связать с любым из находящихся на карте образом. Для этого в командном API предусмотрены специальные вызовы, к которым пользователь получает доступ с помощью программы MOUNT, также являющейся частью проекта. Ее исходные тесты расположены в файле-образе mount/MOUNT.KDI (программа написана на С, транслируется компилятором C80). Скомпилированный вариант MOUNT.COM также расположен на инструментальном диске Е и всегда доступен пользователю.

9.1. Просмотр конфигурации логических дисков.

Если ввести команду MOUNT без параметров, то она покажет текущее назначение каждого логического диска. Например:

A>MOUNT

DIR: DISK

A: => (R/W) DISK/DISKA.KDI

B: => (R/W) DISK/DISKB.KDI

C: => $FDD 0

D: => $FDD 1

Это - стандартная конфигурация для ПК8020. Диски A и B - эмулируемые, и подключены к образам DISKA.KDI и DISKB.KDI, расположенными в каталоге DISK карты. C и D — физические, подключены к дисководам 0 и 1 соответственно. DIR: DISK — информация о текущем каталоге, это означает, что вновь монтируемые образы дисков будут искаться в каталоге DISK. R/W означает, что на диск разрешена запись.

Для ПК8010 конфигурация будет немного другой:

A>MOUNT

DIR: DISK

A: => (R/W) DISK/DISKA.KDI

B: => (R/W) DISK/DISKB.KDI

C: => (R/W) DISK/DISKC.KDI

D: => (R/W) DISK/DISKD.KDI

Поскольку в этой машине отсутствуют физические дисководы, то все 4 логических диска отображаются на эмулируемые образы.

9.1. Монтирование образов дисков.

С помощью команды MOUNT можно изменить конфигурацию логических дисков. Формат командной строки в этом случае будет такой:

MOUNT [/P][/R] drv image

/P — указывает постоянное назначение — оно будет восстановлено после перезагрузки системы, поскольку сохраняется в файле конфигурации MOUNT.CFG.

/R — открывает образ диска в режиме «только чтение». Запись на данный логический диск запрещена, и будет возвращать ошибку. Данное действие эквивалентно заклеиванию прорези на дискете.

Drv — буква назначаемого диска, от А до D. Двоеточие после буквы можно не указывать.

Image — имя файла-образа KDI (расширение файла можно не указывать). Этот файл будет смонтирован к букве диска drv.

Файл будет искаться в текущем каталоге. Текущий каталог можно увидеть в поле DIR:, запустив команду mount без параметров. Как сменить текущий каталог описано далее. Кроме имени файла, в поле image можно указать специальный идентификатор $n, где n — цифра от 0 до 3. Это означает, что к букве диска подключается физический дисковод с указанным номером. Для ПК8010, не имеющего контроллера дисковода, данный идентификатор указывать бессмысленно.

Если файл, указанный в поле image, не найден в текущем каталоге, то логическому диску присваивается статус «не готов» - это эквивалентно выниманию дискеты из реального дисковода.

Примеры:

A>MOUNT C ABRIS

A>MOUNT

DIR: DISK

A: => (R/W) DISK/DISKA.KDI

B: => (R/W) DISK/DISKB.KDI

C: => (R/W) DISK/ABRIS.KDI

D: => $FDD 1

Здесь к логическому диску С подключается образ ABRIS.KDI. Монтирование временное, информация о нем не сохранится после перезагрузки.

A>MOUNT /R D DBASEII

A>MOUNT

DIR: DISK

A: => (R/W) DISK/DISKA.KDI

B: => (R/W) DISK/DISKB.KDI

C: => (R/W) DISK/ABRIS.KDI

D: => (R/O) DISK/DBASEII.KDI

К логическому диску D подключается образ DBASEII.KDI с запрещением записи (ключ /R), что отражается признаком (R/O) в списке. В этой конфигурации мы теряем доступ ко всем физическим дисководам.

A>MOUNT /R B $0

A>MOUNT

DIR: DISK

A: => (R/W) DISK/DISKA.KDI

B: => $FDD 0

C: => (R/W) DISK/ABRIS.KDI

D: => (R/O) DISK/DBASEII.KDI

К логическому диску B подключается физический дисковод 0.

A>MOUNT D TEST

D: Файл не найден

A>MOUNT

DIR: DISK

A: => (R/W) DISK/DISKA.KDI

B: => $FDD 0

C: => (R/W) DISK/ABRIS.KDI

D: => Не смонтирован

К логическому диску D подключается образ test.kdi. Такого образа в текущем каталоге нет, о чем программа нам сообщила. Диску присваивается статус «не смонтирован».

9.2. Просмотр списка образов дисков.

Часто бывает нужно посмотреть, а какие вообще образы дисков имеются в текущем каталоге. Для этого используется ключ /L:

A>MOUNT /L

DIR: DISK

HLP.KDI | DISKB.KDI | TDISK.KDI | SYS.KDI |

DISKA.KDI | OSCPM.KDI | TD.KDI | E.KDI |

DISKC.KDI | OSCPM.KDI | TD.KDI | E.KDI |

-- Всего: 8 --

На экран в 4 колонки выводится список файлов, имеющихся на карте в текущем каталоге.

9.3. Изменение текущего каталога.

Текущий каталог — это каталог, в котором будут искаться файлы образов дисков. Изначально таким каталогом является DISK/. С помощью ключа /F можно изменить его:

MOUNT /F[/P] dir

Новым каталогом по умолчанию назначается каталог dir. Если указать ключ /P — изменение будет сохранено в файле конфигурации и восстановится после перезагрузки системы. Пример:

A>MOUNT /F SYSTEM

DIR: SYSTEM

A>MOUNT

DIR: SYSTEM

A: => (R/W) DISK/DISKA.KDI

B: => $FDD 0

C: => (R/W) DISK/ABRIS.KDI

D: => Не смонтирован

A>MOUNT D PROFFER

A>MOUNT

DIR: SYSTEM

A: => (R/W) DISK/DISKA.KDI

B: => $FDD 0

C: => (R/W) DISK/ABRIS.KDI

D: => (R/W) SYSTEM/PROFFER.KDI

Текущим каталогом назначен каталог SYSTEM/. Обратите внимание, что ранее смонтированные образы остаются привязанными к тем каталогам, откуда они были смонтированы (в данном случае DISK/). Изменение касается только вновь монтируемых образов.

Программа проверяет, имеется ли такой каталог на карте. Если его нет, изменение не производится и выдается сообщение об ошибке.

9.4. Просмотр списка каталогов карты.

По аналогии со списком файлов, можно посмотреть, какие каталоги имеются на карте. Для этого к ключу /L добавляют ключ /F:

A>MOUNT /F/L

DISK | SYSTEM | TOOLS | GAMES |

PROGR |

-- Всего: 5 --

В данном случае на карте имеется 5 каталогов.

9.5. Создание образов дисков.

Имеется возможность создавать пустые образы дисков. Образы всегда создаются в текущем каталоге, они имеют стандартный для Корвета формат: 800К, 2 системные дорожки, 128 записей каталога. На месте системных дорожек записывается только информационный сектор, остальная часть системных дорожек не заполняется. Создается пустой каталог, поэтому диск после создания сразу готов к работе без необходимости форматирования. Операция создания образа занимает некоторое время — около 5 секунд.

Командная строка имеет такой формат:

MOUNT /C drv image

drv — буква логического диска, на которой создается пустой образ.

Image — имя файла создаваемого образа.

Пример.

A>MOUNT /C D NEWIMG

D: Cоздание файла...ok

A>MOUNT

DIR: SYSTEM

A: => (R/W) DISK/DISKA.KDI

B: => $FDD 0

C: => (R/W) DISK/NEWIMG.KDI

D: => (R/W) SYSTEM/NEWIMG.KDI

A>DIR D:

No file

A>

В этом примере создается пустой образ NEWIMG.KDI.

Если файл образа уже существует в текущем каталоге, то операция создания не выполняется, а образ просто монтируется к указанной букве диска.

9.6. Справка по программе.

Программа MOUNT имеет ключ /H, показывающий краткую справку о формате командной строки.

A>MOUNT /H

Формат командной строки:

MOUNT

- без аргументов показывает текущие смонтированные образы

MOUNT /L[/F]

- Выводит список KDI в текущем каталоге, /F - список каталогов

MOUNT /F[/P] DIR

- Устанавливает текущий каталог DIR (/P — навсегда)

MOUNT [ключи] DRV FILE

Подключает образ FILE к логическому диску DRV

FILE - образ KDI или $0($1) - физический FDD 0 или 1

DRV — буква монтируемого диска (A-D)

/R — подключить образ в режиме только чтение

/P — сделать назначение диска постоянным

/C — создать пустой образ диска и смонтировать его

9.7. Инструментальный диск.

Кроме логических дисков A-D, назначаемых пользователем, в системе имеется также инструментальный диск E. На этом диске расположены 3 системные программы — MOUNT, CONTROL и EUNLOCK. Особенность этого диска в том, что он всегда жестко связан с образом EXRTOOLS.DSK, лежащем в корне карты, и не может быть перемонтирован к другому образу. EXRTOOLS.DSK — это не обычный KDI-образ. Его размер всего 144К, и на нем нет информационного сектора и системных дорожек. Именно поэтому ему присвоено расширение DSK, а не KDI - к другим логически дискам примонтировать его невозможно. В дереве проекта этот файл лежит в mount/exrtools.dsk.

Диск этот всегда защищен от записи, во избежании порчи его от случайный действий прикладных программ. Однако предусмотрена возможность снятия этой защиты в целя обновления имеющихся на нем программ. Для этого используется утилита EUNLOCK. После ее запуска диск становится доступным для записи вплоть до следующей полной перезагрузки системы по кнопке RESET или отключения питания.

Вышеперечисленные программы занимают около 30К пространства диска Е. Остальное место можно использовать, например, для записи наиболее часто используемых системных утилит — PIP, STAT и т. д.

9.8. Заметки на будущее.

Многие люди почему-то не любят работать с командной строкой — хотя CP/M только так и умеет общаться с пользователем. Поэтому можно написать полноэкранную графическую программу, выполняющую те же функции. Необходимую информацию можно получить из описания программного API и исходных текстов самой программы MOUNT. Надо только, чтобы кто-нибудь за это взялся.
