retro-pc/korvet-extrom/sch/extrom-controller.png

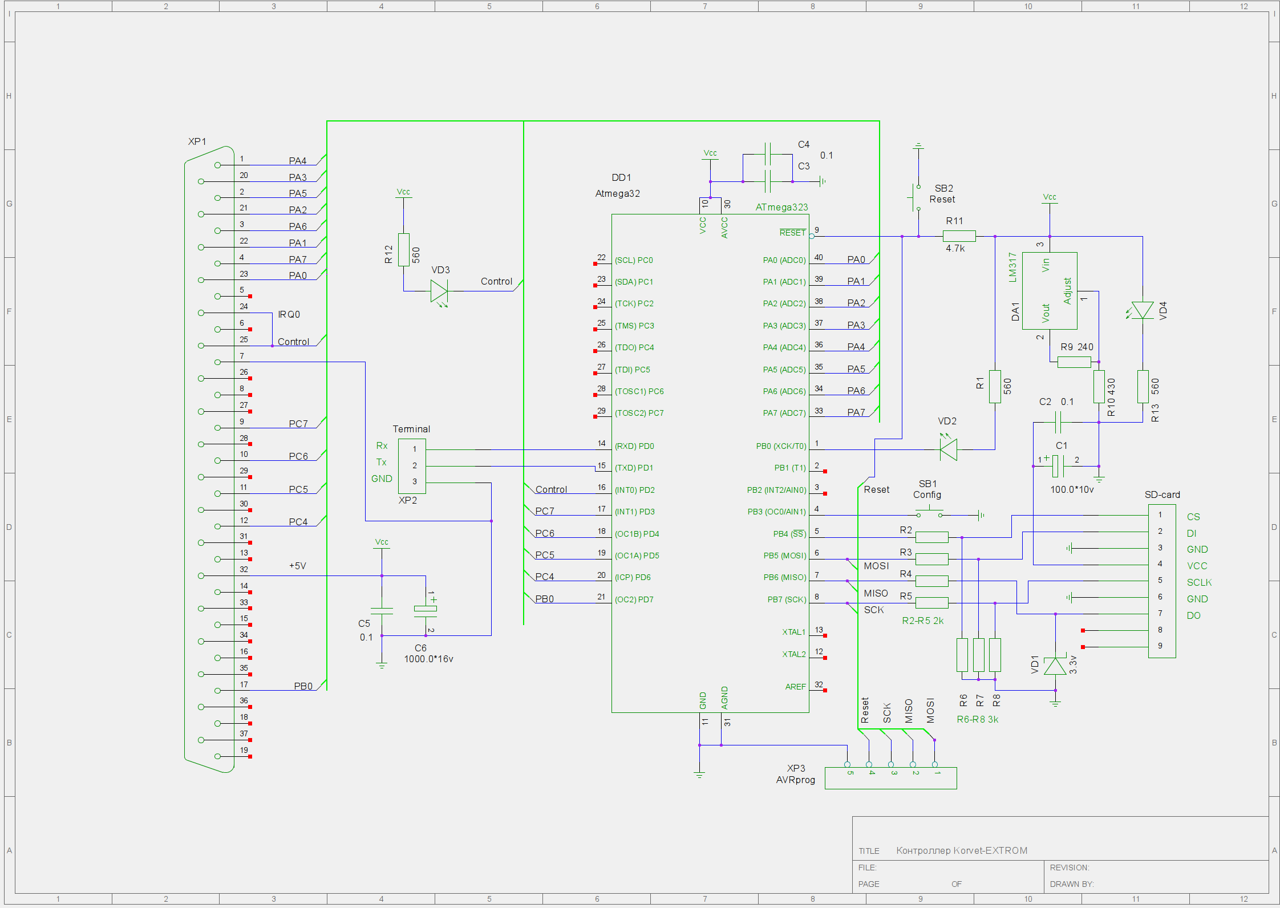
sch/extrom-controller.png
