retro-pc/korvet-extrom/pcb/fdd.pdf

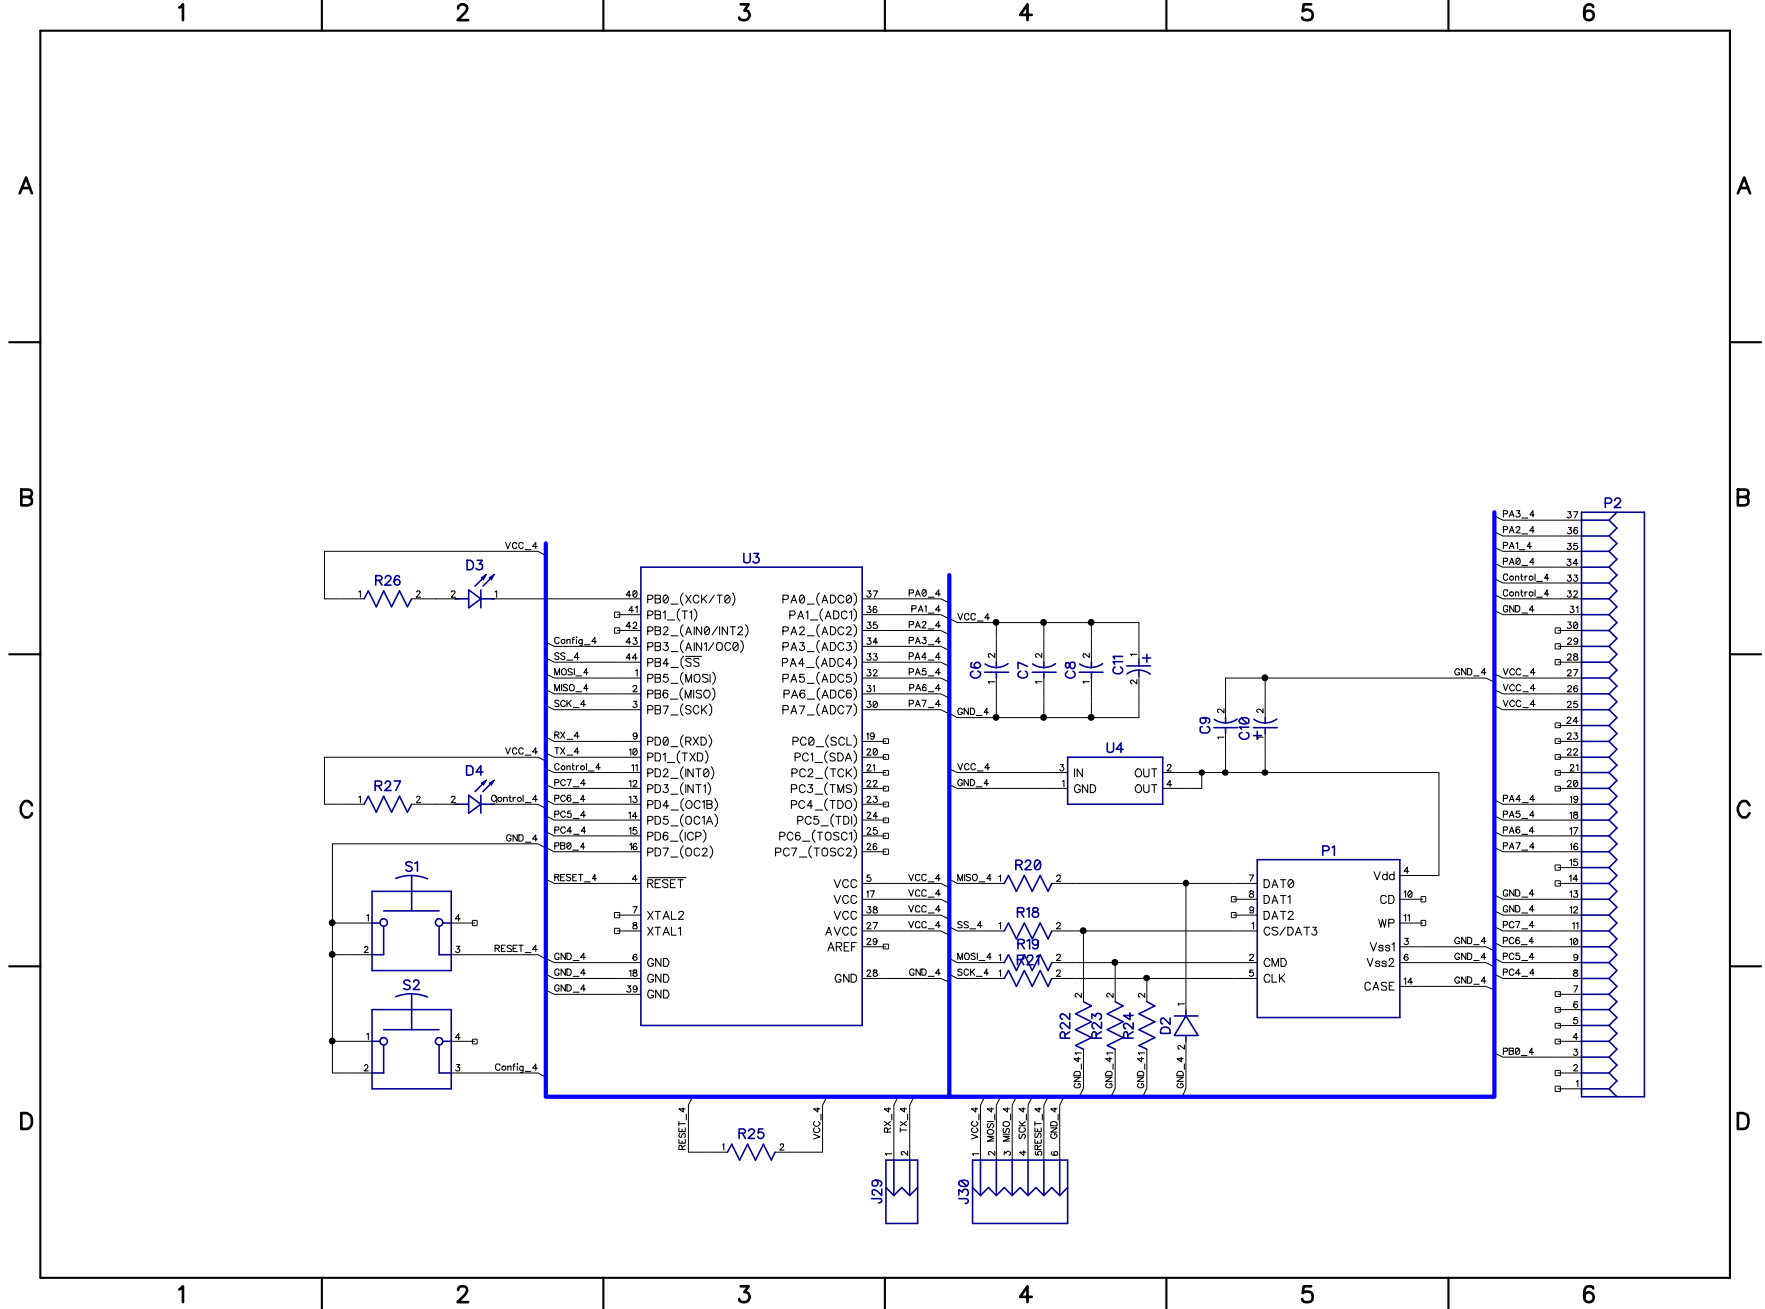
[picture p6: page 1]
