retro-pc/korvet-extrom/sch/extrom-controller.pdf

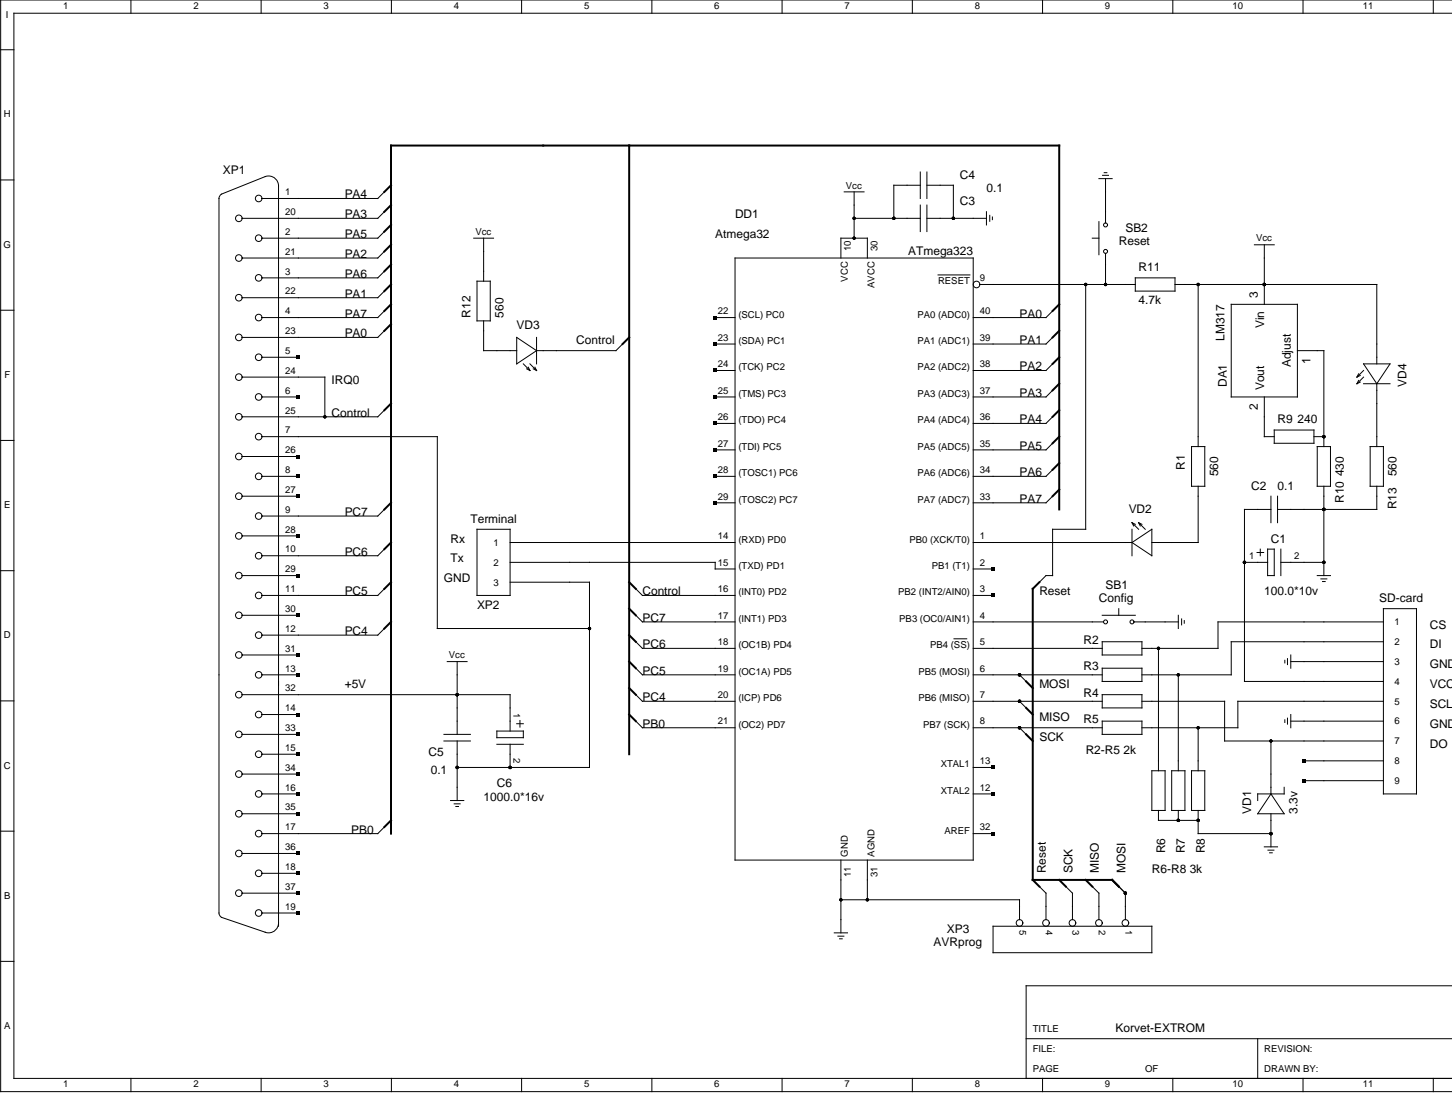
[picture p7: page 1]
