retro-pc/korvet-extrom/(list of files, drawings)

Other design files:
pcb/fdd.dch
pcb/fdd.dip
