retro-pc/korvet-extrom/avr/fs.h

/*
It is an open source software to implement FAT file system to
small embedded systems. This is a free software and is opened for education,
research and commercial developments under license policy of following trems.

(C) 2013 vinxru
(C) 2010, ChaN, all right reserved.

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
Version 0.99 5-05-2013
*/

#ifndef _FS_H_
#define _FS_H_

typedef unsigned char   BYTE;
typedef unsigned int    WORD;
typedef unsigned long	DWORD;

/* Disable checking and kill the file system */
/* С помощью этого макроса можно отключить проеерки, что бы сэкономить ПЗУ и убить файловую систему.*/
/* #define FS_DISABLE_CHECK */

/* Two opened files */
/* Два открытых файла */
/* #define FS_DISABLE_SWAP */

/* Calculation of free disk space */
/* Определение свободного места на диске */
/* #define FS_DISABLE_GETFREESPACE */

/* Work sbuffer for filesystem */
/* Буфер для работы файловой системы */

// Интерфейс к чтению-записи карты

unsigned char read_block(unsigned char* buf, unsigned long adr, unsigned int length, unsigned int offset);
unsigned char write_block(unsigned char* buf,unsigned long adr);


extern unsigned char* getsbufptr();

/* Error */
/* Ошибки файловой системы */

#define ERR_OK              0  // Нет ошибки
#define ERR_NO_FILESYSTEM   1  // Файловая система не обнаружена
#define ERR_DISK_ERR        2  // Ошибка чтения/записи
#define	ERR_NOT_OPENED      3  // Файл/папка не открыта
#define	ERR_NO_PATH         4  // Файл/папка не найдена
#define ERR_DIR_FULL        5  // Папка содержит максимальное кол-во файлов
#define ERR_NO_FREE_SPACE   6  // Нет свободного места
#define ERR_DIR_NOT_EMPTY   7  // Нельзя удалить папку, она не пуста
#define ERR_FILE_EXISTS     8  // Файл/папка с таким именем уже существует
#define ERR_NO_DATA         9  // fs_file_wtotal=0 при вызове функции fs_write_begin
    
#define ERR_MAX_FILES       10 // Не используется файловой системой, резерв
#define ERR_RECV_STRING     11 // Не используется файловой системой, резерв
#define ERR_INVALID_COMMAND 12 // Не используется файловой системой, резерв

#define ERR_ALREADY_OPENED  13 // Файл уже открыт (fs_swap)

/* Filesystem variables. Can change */
/* Переменные файловой системы. Можно изменять */

extern DWORD fs_tmp;
extern BYTE lastError;       /* Последняя ошибка файловой системы или диска */
extern WORD fs_wtotal;       /* Используется функциями fs_write_start, fs_write_end*/

/* Maximal length of file name */
/* Максимальная длина имени */

#define FS_MAXFILE  469

/* Result of fs_readdir */
/* Описатель прочитанный функцией fs_readdir */

#define FS_DIRENTRY  (sbuf + 480)

/* Functions. Returns not 0 if error occured. Destroy sbuf variable*/
/* Функцяии. Возращают не 0, если ошибка. Все функции портят sbuf */

BYTE fs_init();                                  /* Инициалиазция файловой системы / Init filesystem */
BYTE fs_check();                                 /* Проверка наличия диска, и если нужно, то его инициализация / Checking the disk and, if necessary, it will be initialized */
BYTE fs_readdir();                               /* Прочитать содежимое папки в DIRENTRY / Read folder contents in DIRENTRY */
BYTE fs_delete();                                /* Удалить файл или папку, имя в sbuf / Delete file or folder, name in sbuf */
BYTE fs_open0(BYTE what);                        /* Открыть/создать файл или папку, имя в sbuf. Open/create file or foder, name in sbuf */
BYTE fs_move0();                                 /* Переместить файл/папку. Move file or folder, source file must been opened, destination name in sbuf */
BYTE fs_move(const char* from, const char* to);  /* Переместить файл/папку. Move file or folder. */
BYTE fs_lseek(DWORD ptr, BYTE mode);             /* Установить указатель чтения/записи файла, увеличивает размер файла. / Set file pointer, enlarge file size. */
BYTE fs_tell();                                  /* Получить указатель чтения/записи файла в fs_tmp / Get file pointer in fs_tmp. */
BYTE fs_getfilesize();                           /* Получить размер файла / Get file size. */
BYTE fs_read0(BYTE* ptr, WORD len);              /* Прочитать из файла. НЕЛЬЗЯ ВЫХОДИТЬ ЗА ПРЕДЕЛЫ ФАЙЛА! / Read from the file, DO NOT COME OUT FILE */
BYTE fs_read(BYTE* ptr, WORD len, WORD* readed); /* Прочитать из файла. / Read from the file. */
BYTE fs_write(BYTE* ptr, WORD len);        /* Записать в файл, увеличивает размер файла. / Записать в файл, enlarge file size. */
BYTE fs_write_eof();                             /* Установить конец файла, уменьшает размер файла. / Set end of file, reduces file size */
BYTE fs_gettotal();                              /* Общее место на диске в fs_tmp в мегабайтах / Total disk space in fs_tmp (megabytes) */

#ifndef FS_DISABLE_SWAP
void fs_select(char fn);                         /* Переключится на другой файл / Switch to the second file */
#endif

#ifndef FS_DISABLE_GETFREESPACE
BYTE fs_getfree();                               /* Свободное место на диске в fs_tmp  в мегабайтах / Free disk space in fs_tmp (megabytes) */
#endif


/* Функции ниже позволяют использовать для записи буфер (sbuf).
*  The functions below can be used to write the sbuffer (sbuf).
*
*  wtotal = размер данных для записи;
*  while(wtotal) {
*    fs_write_start(&wtotal);
*    Копируем fs_file_wlen байт в fs_file_wsbuf
*    Ни одна функция ФС не должеа выпонятсья между ними
*    fs_write_end(&wtotal);
*  }
*
* See the source of fs_write
* Или смотри исходники fs_write
*/

#define fs_file_wlen   (*(WORD*)&fs_tmp)
#define fs_file_woff   ((WORD*)&fs_tmp)[1]
#define fs_file_wsbuf   (sbuf + fs_file_woff)

BYTE fs_write_start(); 
BYTE fs_write_end();

/* Derived from the function fs_open0 */
/* Производные от функции fs_open0 */

BYTE fs_open();                                  /* Открыть файл */
BYTE fs_opendir();                               /* Открыть папку */
#define fs_openany()    fs_open0(OPENED_NONE)    /* Открыть файл или папку */
#define fs_create()     fs_open0(OPENED_FILE)    /* Создать файл */
#define fs_createdir()  fs_open0(OPENED_DIR)     /* Создать папку */


/* Values ??fs_opened */
/* Значения fs_opened */

#define OPENED_NONE    0
#define OPENED_FILE    1
#define OPENED_DIR     2

/* File attributes */
/* Атрибуты файлов */

#define	AM_RDO         0x01  /* Read only */
#define	AM_HID         0x02  /* Hidden */
#define	AM_SYS         0x04  /* System */
#define	AM_VOL         0x08  /* Volume label */
#define AM_DIR         0x10  /* Directory */
#define AM_ARC         0x20  /* Archive */

/* Fodler descriptor (FS_DIRENTRY) */
/* Описатель */

#define	DIR_Name       0
#define	DIR_Attr       11
#define	DIR_NTres      12
#define	DIR_CrtTime    14
#define	DIR_CrtDate    16
#define	DIR_FstClusHI  20
#define	DIR_WrtTime    22
#define	DIR_WrtDate    24
#define	DIR_FstClusLO  26
#define	DIR_FileSize   28

#endif
