retro-pc/korvet-extrom/zmac/doc.c

// Output documentation in HTML format.

#include <stdio.h>
#include <string.h>

#ifdef MK_DOC
#define DOC_DEBUG
int main(int argc, char *argv[])
{
	void doc(void);

	doc();

	return 0;
}
#endif

// Define this to have zmac read from "doc.txt" instead of using the
// internal copy.  It also overwrites the internal copy thus providing
// a way to generate "doc.inl".
//#define DOC_DEBUG

#ifdef DOC_DEBUG
static FILE *fp, *inl;
#define next()	fgetc(fp)
#else
#include "doc.inl"
#define next() *dp++
#endif

static int tt = 0;

static void print(char *str);

void doc(void)
{
	char line[1024], *p;
	int ch;
	int table = 0, tcol = 0;
	int blockquote = 0;

#ifdef DOC_DEBUG
	fp = fopen("doc.txt", "r");
	if (!fp) {
		fprintf(stderr, "Cannot open 'doc.txt'\n");
		return;
	}
	inl = fopen("doc.inl", "w");
	if (!inl) {
		fprintf(stderr, "Cannot write 'doc.inl'\n");
		return;
	}
	fprintf(inl, "static char *documentation =\n");
#else
	char *dp = documentation;
#endif

	for (;;) {
		p = line;
		for (;;) {
			ch = next();
			if (ch <= 0 || ch == '\n')
				break;

			*p++ = ch;
		}
		if (ch <= 0)
			break;

		*p = '\0';

#ifdef DOC_DEBUG
		if (inl) {
			fprintf(inl, "\t\"");
			for (p = line; *p; p++) {
				if (*p == '"' || *p == '\\')
					fprintf(inl, "\\");
				fprintf(inl, "%c", *p);
			}
			fprintf(inl, "\\n\"\n");
		}
#endif

		// An initial '|' means part of a block quote
		if (*line == '|') {
			if (!blockquote)
				printf("<BLOCKQUOTE>");

			blockquote = 1;
			print(line + 1);
			printf("\n");
			continue;
		}

		if (blockquote) {
			printf("</BLOCKQUOTE>\n");
			blockquote = 0;
		}

		// Start with space means you're a table element.
		// Number of spaces indicate which column.  If not, then we drop
		// out of table mode.  Nothing after the spaces is a special case
		// to remain in table mode.
		if (*line == ' ') {
			int depth = 0;
			for (p = line; *p == ' '; p++)
				depth++;

			if (*p == '\0' && depth == 1)
				continue;

			if (!table) {
				printf("<TABLE>\n");
				table = 1;
				tcol = 0;
			}

			if (depth < tcol) {
				printf("</TD></TR>\n");
				tcol = 0;
			}

			if (tcol == 0) {
				printf("<TR><TD VALIGN=\"TOP\">");
				printf("<PRE>"); // Column 1 is fixed width font for us
				tcol = 1;
			}

			while (tcol < depth) {
				if (tcol == 1)
					printf("</PRE>"); // Column 1 is fixed width font for us
				printf("</TD><TD>");
				tcol++;
			}

			print(p);
			printf(" ");
			continue;
		}
		else if (table) {
			if (tcol)
				printf("</TD></TR>\n");

			printf("</TABLE>\n");
			table = 0;
		}

		// Line starting with '-' generates a full horizontal rule
		if (*line == '-') {
			printf("<HR>\n");
			continue;
		}
		// Empty line denotes paragraph separation
		if (*line == '\0') {
			printf("<P>\n");
			continue;
		}
		// Initial . for a heading.  More . for a lesser heading.
		if (*line == '.') {
			for (p = line; *p == '.'; p++)
				;
			printf("<H%d>", 3 + (int)(p - line - 1));
			print(p);
			printf("</H%d>\n", 3 + (int)(p - line - 1));
			continue;
		}

		print(line);
		printf("\n");
	}

	if (tt)
		printf("</TT>\n");

	printf("<!--\n");
	printf("  If you ran \"zmac --doc\" you may want to send the output\n");
	printf("  to a file using \"zmac --doc >zmac.html\" and then open\n");
	printf("  zmac.html in your web browser.\n");
	printf("-->\n");

#ifdef DOC_DEBUG
	fclose(fp);
	if (inl) {
		fprintf(inl, ";\n");
		fclose(inl);
	}
#endif
}

static void link(char *str, char how)
{
	char *id = strchr(str, how);
	char *text = id, save, *id_end;
	int len = 0, spccnt;

	while (id[len] == how)
		len++;

	for (id_end = id + len; *id_end >= 'a' && *id_end <= 'z'; id_end++)
		;

	spccnt = len;
	do {
		if (text > str)
			text--;

		while (text > str && *text != ' ')
			text--;

		spccnt--;
	}
	while (spccnt > 0);

	if (*text == ' ')
		text++;

	save = *text;
	*text = '\0';
	print(str);
	*text = save;

	save = *id_end;
	*id_end = '\0';
	printf("<A ");
	if (how == '@')
		printf("HREF=\"#");
	else
		printf("NAME=\"");
	printf("%s\">", id + len);
	*id_end = save;

	save = *id;
	*id = '\0';
	print(text);
	*id = save;

	printf("</A>");

	print(id_end);
}

// Output string with HTML escaping and certain internal metacharacter handling.

static void print(char *str)
{
	// Check for @id (link-to) and \id (link-target) specifiers.
	char *to = strchr(str, '@');
	char *target = strchr(str, '\\');

	if (to && !((to[1] >= 'a' && to[1] <= 'z') || to[1] == '@'))
		to = 0;

	if (target && !((target[1] >= 'a' && target[1] <= 'z') || target[1] == '@'))
		target = 0;

	if (to && target && target < to)
		to = 0;

	if (to && target && to < target)
		target = 0;

	if (to) {
		link(str, '@');
		return;
	}
	else if (target) {
		link(str, '\\');
		return;
	}

	while (*str) {
		// Two or more ## mean N-1 non-breaking spaces.
		if (str[0] == '#' && str[1] == '#') {
			int n = 0;
			for (; *str == '#'; str++)
				n++;

			while (n-- > 1)
				printf("&nbsp;");

			continue;
		}

		if (*str == '_') {
			if (str[1] == '_') {
				printf("_");
				str++;
			}
			else {
				printf("<%sTT>", tt ? "/" : "");
				tt = !tt;
			}
		}
		else if (*str == '<')
			printf("&lt;");
		else if (*str == '>')
			printf("&gt;");
		else if (*str == '&')
			printf("&amp;");
		else
			printf("%c", *str);

		str++;
	}
}
