retro-pc/korvet-extrom/(commit log)

2014-07-23 Первая загрузка файлов в репозиторий
    [extrom-controller.sch]
2014-07-23 Добавлена документация
2014-07-24 Исправлена работа команды A0
    [extrom.c]
2014-07-24 Изменеа процедура начального монтирования образов
2014-07-24 В BIOS добавлено автоопределение наличия контроллера FDD. Если его нет, то все 4 диска становятся эмулируемыми.
2014-07-24 Обновлена документация
2014-07-26 Добавлен образ диска с программой mount
2014-07-28 Доделка документации
2014-07-28 Поправлена программа MOUNT Серьезно дописана главная дока.
2014-07-29 изменена структура дерева проекта
2014-07-30 добавлен диск E в прошивку
2014-07-31 попытка 1 добавить диск E, нерабочая
2014-08-05 Обновлен BIOS и mount для поддержки диска E
2014-08-05 Обновлена прошивка для поддержки диска E
2014-08-05 Добавлены файлы для обновления эмулятора, чтобы не таскать их отдельно
2014-08-06 Обновлен mount и добавлен инструментальный диск EXRTOOLS
2014-08-17 Доделана прошивка и эмулятор для защиты записи диска Е Реализована команда API 88 Поправленана документация по API Создана программа EUNLOCK для снятия защиты записи с диска Е
2014-08-18 Функция управления линией CONTROL вынесена в отдельную программу Добавлена утилита CONTROL
2014-08-18 Исправлены комментарии в BIOS
2014-08-18 В дерево проекта добавлен универсальный загрузчик фазы 2 от ESL
2014-08-18 Наконец доисправлена документация
2014-08-18 Добавлен ассемблер ZMAC в дерево проекта
2014-08-18 Исправлена документация
2014-08-24 Начал писать доку по железу
2014-08-25 Пишется документация по железу
2014-08-26 Дописан еще один кусок доки по железу
    [extrom-controller.sch]
2014-08-26 Принципиальная схема приведена в соответствие со спецификацией и докой
    [extrom-controller.sch]
2014-08-31 Исправил описание API для исключения неоднозначности
2014-09-02 Очередноая глава доки по железу
    [serial.sch]
2014-09-02 Добавлен выбор скорости порта терминала
2014-09-02 Вроде дописан черновой вариант доки по железу. Заодно сделана пара мелких изменений в прошивке контроллера.
2014-09-02 Небольшая правка документации перед публикацией на форуме
2014-10-24 latest stage2 loader with patcher SD_ROOT folder latest ZMAC latest emulator patch
    [PATCHER.ods, layout.ods, patcher-data-cpm1.csv, patcher-data-cpm2.csv, patcher-data-cpm_chk.csv, patcher-data-microdos.csv, patcher-data-unsupported.csv]
2015-03-08 binary HEX for avr added, xboot renamed to stage1, buildscripts for stage1 and avr flash
2015-03-08 history added, avr firmware work with stage2
2015-04-02 add todo, schematic as pdf, and minor bug
    [extrom.c]
2015-04-21 Stage2 boot show boot image name
2024-03-18 from zx-pk.com
    [fdd.dch, fdd.dip]
